OisinS13/FC_IP_rig/Control code/Interface/menu_outline.docx

1. Procedures
  1.1. Start up
  1.2. Shutdown
  1.3. Calibrate
  1.4. Idle
2. Settings
  2.1. CVM
  2.2. Data Logger
  2.3. Interface
  2.4. Load controller
  2.5. Process controller
    2.5.1. Fetch settings
    2.5.2. FTC_low_temp_thresh
    2.5.3. TC_high_temp_thresh
    2.5.4. TC_high_temp_thresh_warning_buffer
    2.5.5. Cathode_target_T
    2.5.6. Cathode_T_Hysteresis
    2.5.7. Cathode_flow_sensor_minimum_thresh
    2.5.8. CTHD_FLW_stoich
    2.5.9. CTHD_FLW_min
    2.5.10. Coolant_T_target
    2.5.11. Coolant_T_Hysteresis
    2.5.12. Coolant_high_temp_thresh
    2.5.13. Coolant_high_temp_warning_buffer
    2.5.14. HIH6120_address[8]
    2.5.15. HIH6120_flags
    2.5.16. HIH_interval
    2.5.17. P_sig_flags
    2.5.18. Pressure_sensor_minimum_threshold
    2.5.19. H2N2_flag
    2.5.20. Data_interval
  2.6. Safety controller
