OisinS13/FC_IP_rig/Hardware/Interface and data logger/JLC_BOM.xlsx

Comment | Designator | Footprint | JLCPCB Part #（optional）
5.6k | R1, R2, R3, R4, R5, R6, R7, R8, R9, R10, R11, R12, R13, R14, R15, R16, R17, R18, R19, R20, R21, R22, R23, R24, R25, R26, R27, R28, R29, R30, R31, R32, R33, R34, R35, R36, R37, R38, R39, R40, R41, R42, R43, R44, R45, R46, R47, R48, R49, R50, R51, R52, R53, R54, R55, R56, | Resistor_SMD:R_0603_1608Metric_Pad0.98x0.95mm_HandSolder | C23189
BSS138 | Q1, Q2, Q3, Q4, Q5, Q6, Q7, Q8, Q9, Q10, Q11, Q12, Q13, Q14, Q15, Q16, Q17, Q18, Q19, Q20, Q21, Q22, Q23, Q24, Q25, Q26, Q27, Q28, | Package_TO_SOT_SMD:SOT-23 | C112239
