OisinS13/FC_IP_rig/Hardware/gas sniffer/Fab_outs/gas sniffer-NPTH-drl-drl_map.dxf

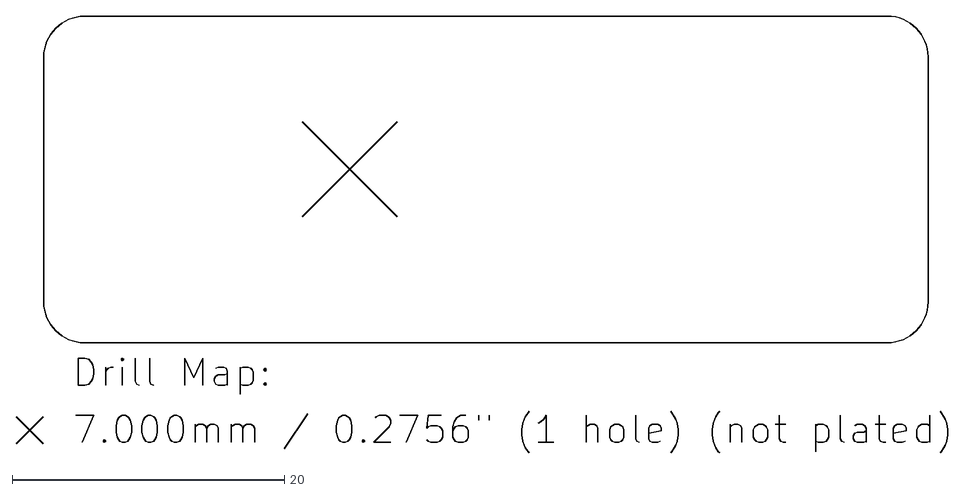
[picture p1: CAD file, 2022-11-23]
Hardware/gas sniffer/Fab_outs/gas sniffer-NPTH-drl-drl_map.dxf
68.5 x 32.1
