OisinS13/FC_IP_rig/Hardware/gas sniffer/Fab_outs/gas sniffer-PTH-drl-drl_map.dxf

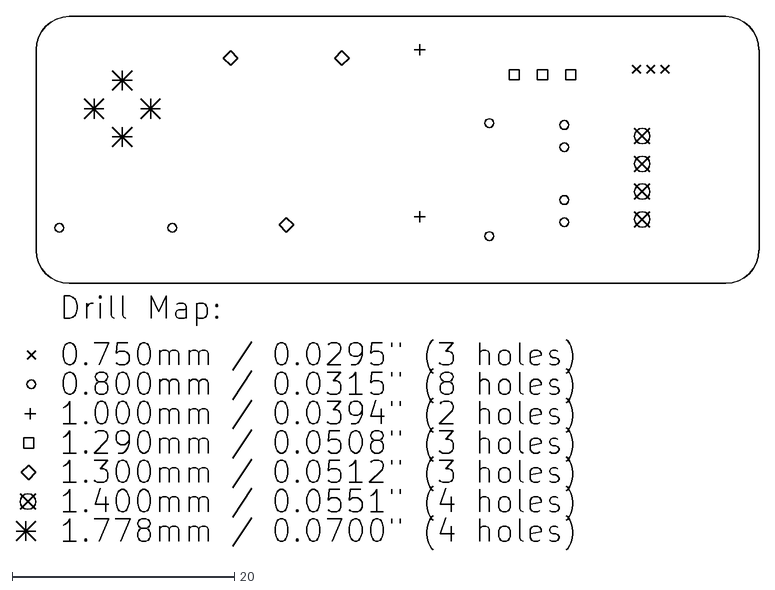
[picture p2: CAD file, 2022-11-23]
Hardware/gas sniffer/Fab_outs/gas sniffer-PTH-drl-drl_map.dxf
66.8 x 47.9
