OisinS13/FC_IP_rig/Hardware/Load controller/controlCircuit.pdf

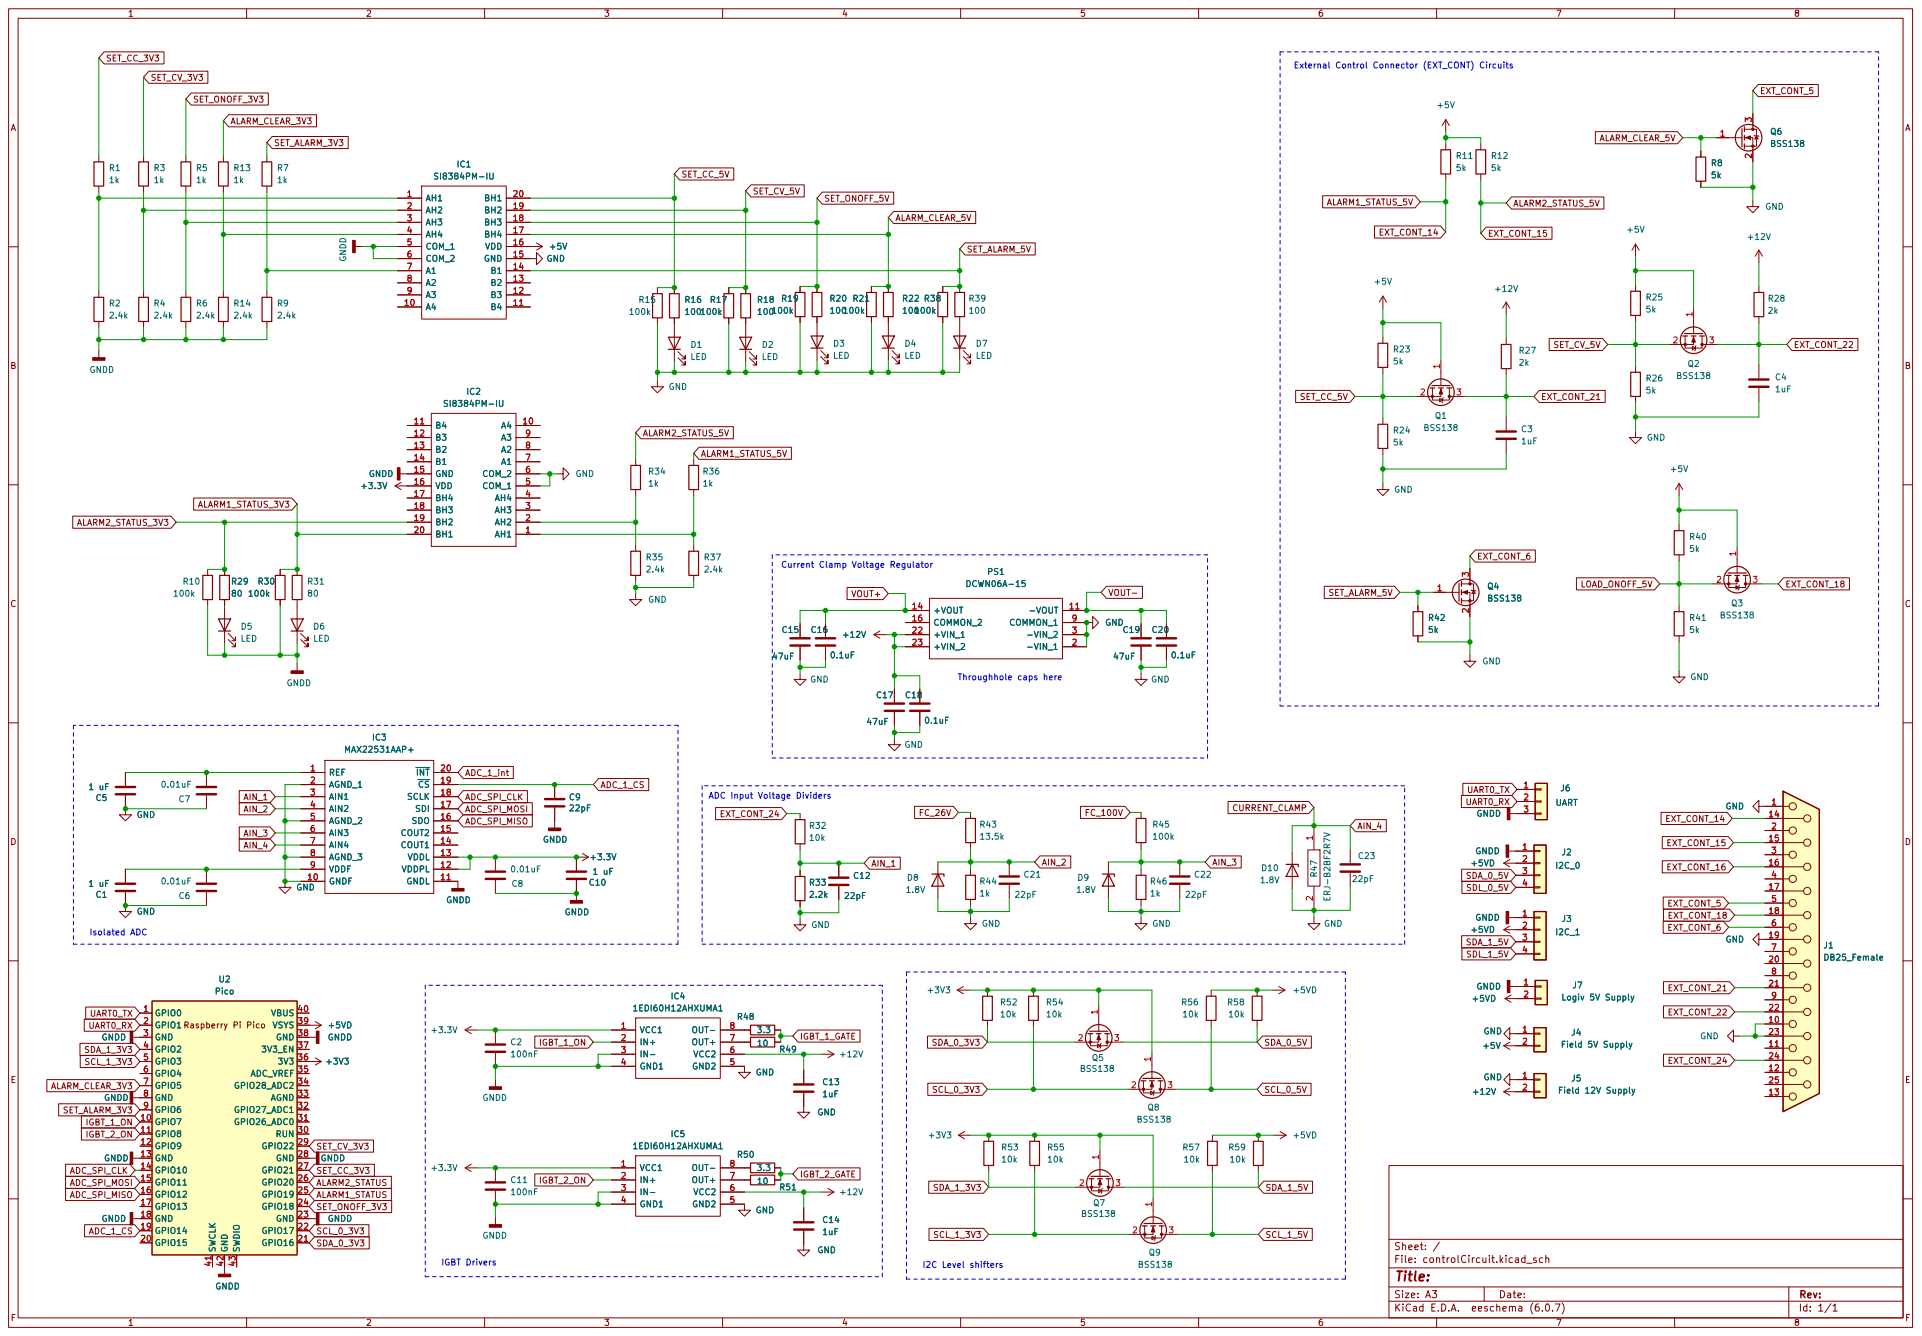
[picture p3: page 1]

External Control Connector (EXT_CONT) Circuits
EXT_CONT_21ALARM_CLEAR_5V

Current Clamp Voltage Regulator

ADC Input Voltage Dividers

+5VD GNDD GND GNDD GND

Isolated ADC
