OisinS13/FC_IP_rig/(list of files, drawings)

Other design files:
Hardware/CVM/iso_adc_cvm.dsn
Hardware/gas sniffer/gas sniffer.dsn
Hardware/Interface and data logger/Interface.dsn
Hardware/Process and safety controller/SCU rig control.dsn
Hardware/Process and safety controller/SCU rig control_ICAH.dsn
