OisinS13/FC_IP_rig/Hardware/Process and safety controller/SCU rig control.kicad_pcb

## KiCad design Hardware/Process and safety controller/SCU rig control.kicad_pcb (2022-11-23)

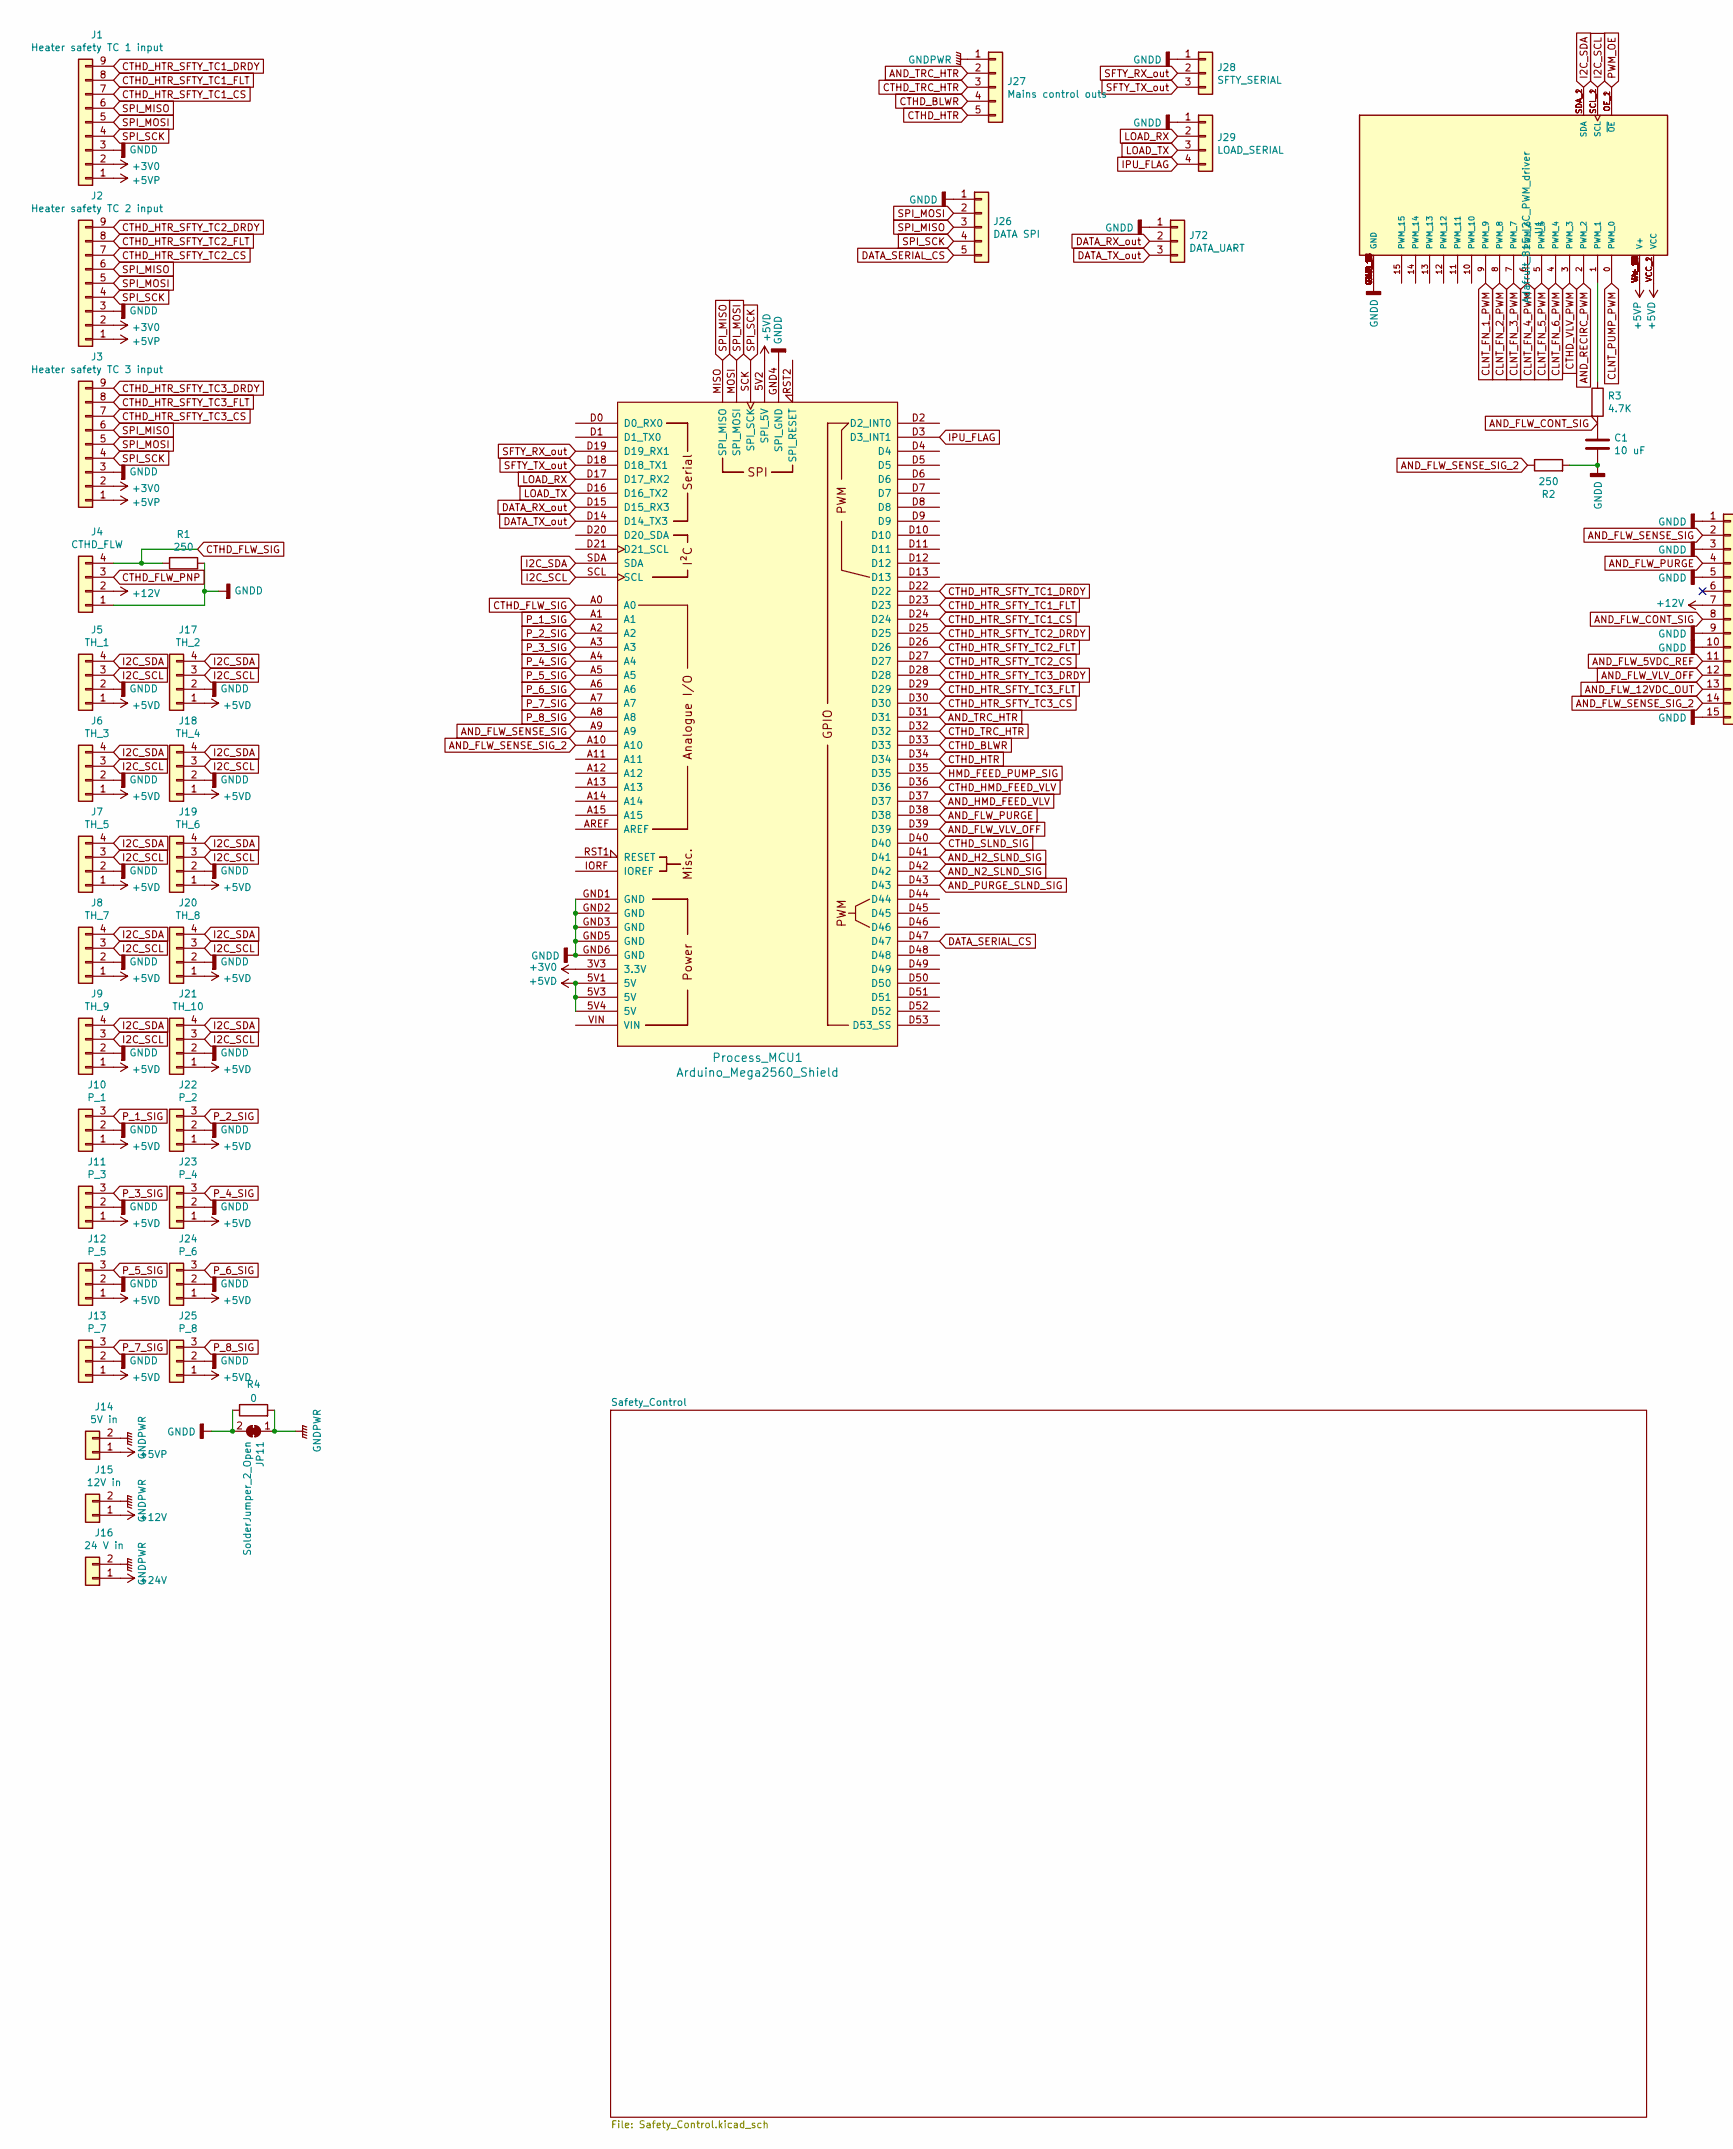
[picture p4: schematic SCU rig control.kicad_sch, part in row 1, column 1]

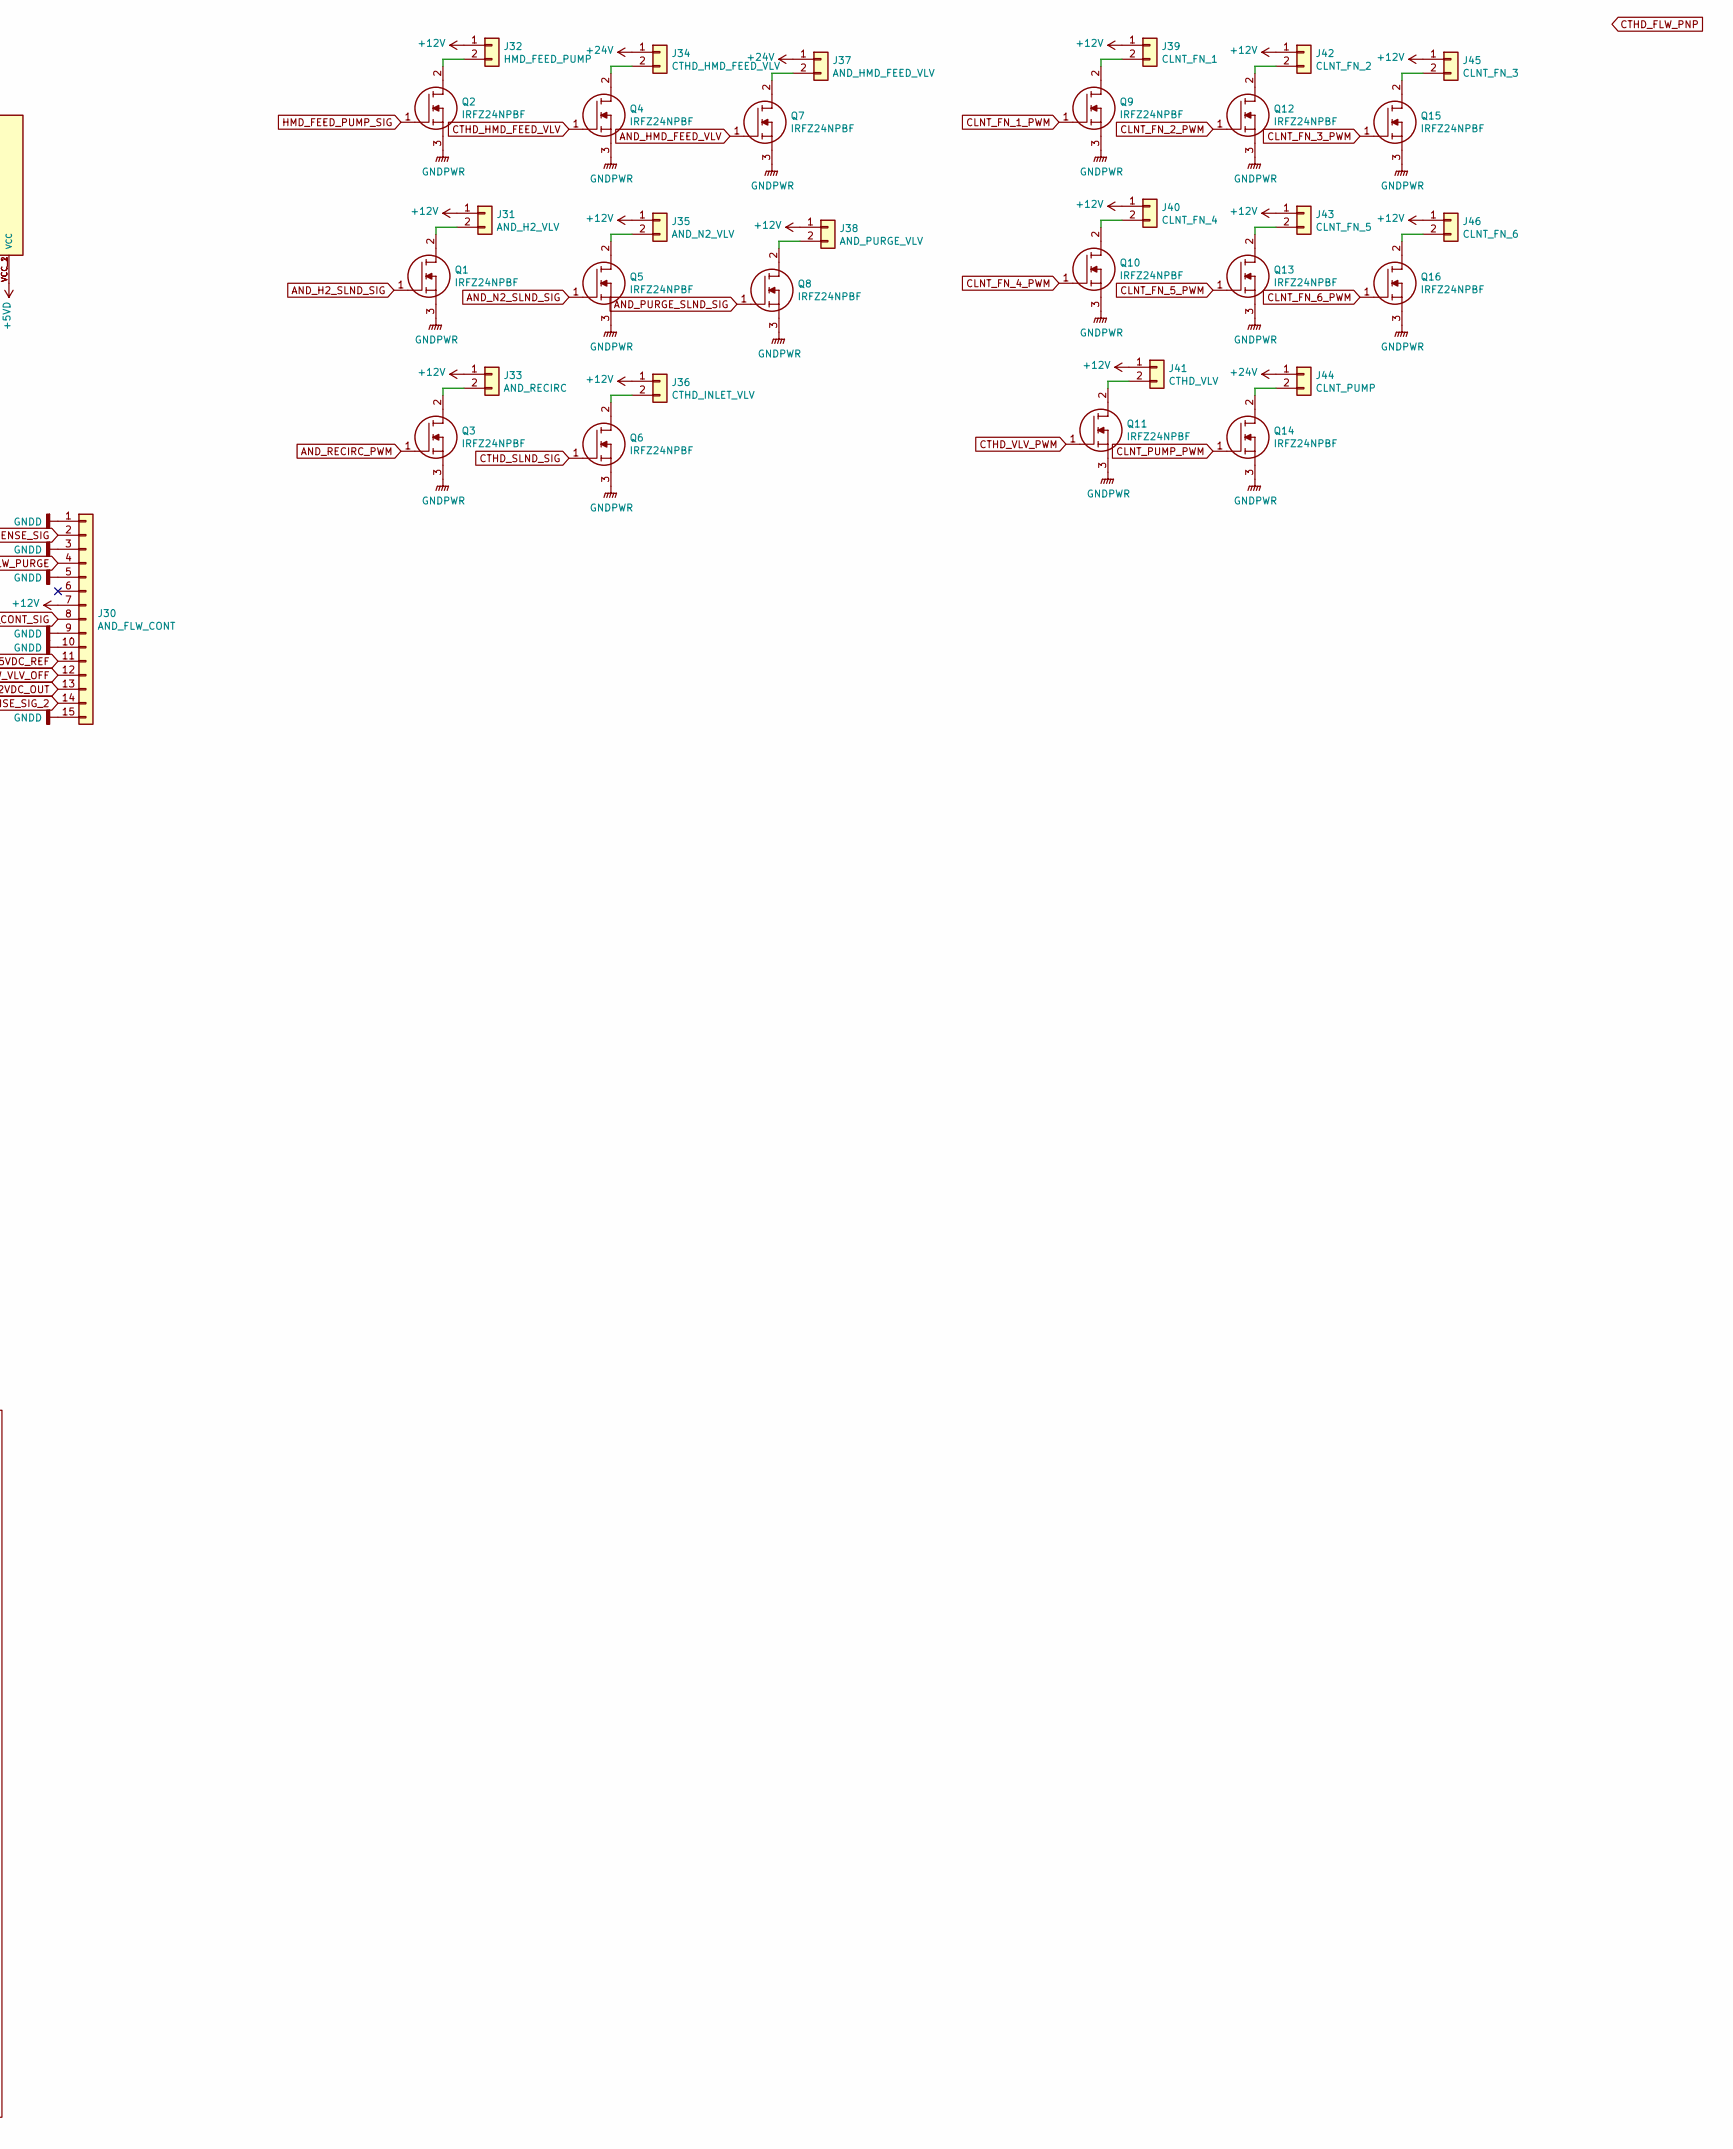
[picture p5: schematic SCU rig control.kicad_sch, part in row 1, column 2]

Parts:
C1: 10 uF; CP_Radial_D5.0mm_P2.00mm
J1: Heater safety TC 1 input; Adafruit_3263
J2: Heater safety TC 2 input; Adafruit_3263
J3: Heater safety TC 3 input; Adafruit_3263
J4: CTHD_FLW; 1963557
J5: TH_1; 1963557
J6: TH_3; 1963557
J7: TH_5; 1963557
J8: TH_7; 1963557
J9: TH_9; 1963557
J10: P_1; 1963544
J11: P_3; 1963544
J12: P_5; 1963544
J13: P_7; 1963544
J14: 5V in; 1963531
J15: 12V in; SolderWirePad_1x02_P7.62mm_Drill2.5mm
J16: 24 V in; SolderWirePad_1x02_P7.62mm_Drill2.5mm
J17: TH_2; 1963557
J18: TH_4; 1963557
J19: TH_6; 1963557
J20: TH_8; 1963557
J21: TH_10; 1963557
J22: P_2; 1963544
J23: P_4; 1963544
J24: P_6; 1963544
J25: P_8; 1963544
J26: DATA SPI; 1881587
J27: Mains control outs; 1881587
J28: SFTY_SERIAL; 1963544
J29: LOAD_SERIAL; 1963557
J30: AND_FLW_CONT; DSUB-15_Male_Vertical_P2.77x2.84mm
J31: AND_H2_VLV; 1963531
J32: HMD_FEED_PUMP; 1963531
J33: AND_RECIRC; 1963531
J34: CTHD_HMD_FEED_VLV; 1963531
J35: AND_N2_VLV; 1963531
J36: CTHD_INLET_VLV; 1963531
J37: AND_HMD_FEED_VLV; 1963531
J38: AND_PURGE_VLV; 1963531
J39: CLNT_FN_1; 1963531
J40: CLNT_FN_4; 1963531
J41: CTHD_VLV; 1963531
J42: CLNT_FN_2; 1963531
J43: CLNT_FN_5; 1963531
J44: CLNT_PUMP; 1963531
J45: CLNT_FN_3; 1963531
J46: CLNT_FN_6; 1963531
J72: DATA_UART; 1963544
JP11: SolderJumper_2_Open; SolderJumper-2_P1.3mm_Bridged2Bar_RoundedPad1.0x1.5mm
Process_MCU1: Arduino_Mega2560_Shield
Q1, Q2, Q3, Q4, Q5, Q6, Q7, Q8, Q9, Q10, Q11, Q12, Q13, Q14, Q15, Q16: IRFZ24NPBF; TO254P469X1042X1967-3P; Mouser Part Number 942-IRFZ24NPBF
R1, R2: 250; R_Axial_DIN0411_L9.9mm_D3.6mm_P15.24mm_Horizontal
R3: 4.7K; R_Axial_DIN0411_L9.9mm_D3.6mm_P15.24mm_Horizontal
R4: 0; R_Axial_DIN0411_L9.9mm_D3.6mm_P15.24mm_Horizontal
U1: Adafruit_815_I2C_PWM_driver; MODULE_815

Connections:
+3V0: J1.2, J2.2, J3.2, Process_MCU1.3V3 (3.3V)
+5VD: J5.1, J6.1, J7.1, J8.1, J9.1, J10.1, J11.1, J12.1, J13.1, J17.1, J18.1, J19.1, J20.1, J21.1, J22.1, J23.1, J24.1, J25.1, Process_MCU1.5V1 (5V), Process_MCU1.5V2 (SPI_5V), Process_MCU1.5V3 (5V), Process_MCU1.5V4 (5V), U1.VCC_1 (VCC), U1.VCC_2 (VCC)
+5VP: J1.1, J2.1, J3.1, J14.1, U1.V+_1 (V+), U1.V+_2 (V+), U1.V+_3 (V+), U1.V+_4 (V+), U1.V+_5 (V+), U1.V+_6 (V+), U1.V+_7 (V+), U1.V+_8 (V+), U1.V+_9 (V+), U1.V+_10 (V+), U1.V+_11 (V+), U1.V+_12 (V+), U1.V+_13 (V+), U1.V+_14 (V+), U1.V+_15 (V+), U1.V+_16 (V+), U1.V+_17 (V+), U1.V+_18 (V+)
+12V: J4.2, J15.1, J30.7, J31.1, J32.1, J33.1, J35.1, J36.1, J38.1, J39.1, J40.1, J41.1, J42.1, J43.1, J45.1, J46.1
+24V: J16.1, J34.1, J37.1, J44.1
AND_FLW_5VDC_REF: J30.11
AND_FLW_12VDC_OUT: J30.13
AND_FLW_CONT_SIG: C1.1, J30.8, R3.2
AND_FLW_PURGE: J30.4, Process_MCU1.D38
AND_FLW_SENSE_SIG: J30.2, Process_MCU1.A9
AND_FLW_SENSE_SIG_2: J30.14, Process_MCU1.A10, R2.1
AND_FLW_VLV_OFF: J30.12, Process_MCU1.D39
AND_H2_SLND_SIG: Process_MCU1.D41, Q1.1
AND_HMD_FEED_VLV: Process_MCU1.D37, Q7.1
AND_N2_SLND_SIG: Process_MCU1.D42, Q5.1
AND_PURGE_SLND_SIG: Process_MCU1.D43, Q8.1
AND_RECIRC_PWM: Q3.1, U1.2 (PWM_2)
AND_TRC_HTR: J27.2, Process_MCU1.D31
CLNT_FN_1_PWM: Q9.1, U1.9 (PWM_9)
CLNT_FN_2_PWM: Q12.1, U1.8 (PWM_8)
CLNT_FN_3_PWM: Q15.1, U1.7 (PWM_7)
CLNT_FN_4_PWM: Q10.1, U1.6 (PWM_6)
CLNT_FN_5_PWM: Q13.1, U1.5 (PWM_5)
CLNT_FN_6_PWM: Q16.1, U1.4 (PWM_4)
CLNT_PUMP_PWM: Q14.1, U1.0 (PWM_0)
CTHD_BLWR: J27.4, Process_MCU1.D33
CTHD_FLW_PNP: J4.3
CTHD_FLW_SIG: J4.4, Process_MCU1.A0, R1.2
CTHD_HMD_FEED_VLV: Process_MCU1.D36, Q4.1
CTHD_HTR: J27.5, Process_MCU1.D34
CTHD_HTR_SFTY_TC1_CS: J1.7, Process_MCU1.D24
CTHD_HTR_SFTY_TC1_DRDY: J1.9, Process_MCU1.D22
CTHD_HTR_SFTY_TC1_FLT: J1.8, Process_MCU1.D23
CTHD_HTR_SFTY_TC2_CS: J2.7, Process_MCU1.D27
CTHD_HTR_SFTY_TC2_DRDY: J2.9, Process_MCU1.D25
CTHD_HTR_SFTY_TC2_FLT: J2.8, Process_MCU1.D26
CTHD_HTR_SFTY_TC3_CS: J3.7, Process_MCU1.D30
CTHD_HTR_SFTY_TC3_DRDY: J3.9, Process_MCU1.D28
CTHD_HTR_SFTY_TC3_FLT: J3.8, Process_MCU1.D29
CTHD_SLND_SIG: Process_MCU1.D40, Q6.1
CTHD_TRC_HTR: J27.3, Process_MCU1.D32
CTHD_VLV_PWM: Q11.1, U1.3 (PWM_3)
DATA_RX_out: J72.2, Process_MCU1.D15 (D15_RX3)
DATA_SERIAL_CS: J26.5, Process_MCU1.D47
DATA_TX_out: J72.3, Process_MCU1.D14 (D14_TX3)
GNDD: C1.2, J1.3, J2.3, J3.3, J4.1, J5.2, J6.2, J7.2, J8.2, J9.2, J10.2, J11.2, J12.2, J13.2, J17.2, J18.2, J19.2, J20.2, J21.2, J22.2, J23.2, J24.2, J25.2, J26.1, J28.1, J29.1, J30.1, J30.3, J30.5, J30.9, J30.10, J30.15, J72.1, JP11.2 (B), Process_MCU1.GND1 (GND), Process_MCU1.GND2 (GND), Process_MCU1.GND3 (GND), Process_MCU1.GND4 (SPI_GND), Process_MCU1.GND5 (GND), Process_MCU1.GND6 (GND), R1.1, R2.2, R4.1, U1.GND_1 (GND), U1.GND_2 (GND), U1.GND_3 (GND), U1.GND_4 (GND), U1.GND_5 (GND), U1.GND_6 (GND), U1.GND_7 (GND), U1.GND_8 (GND), U1.GND_9 (GND), U1.GND_10 (GND), U1.GND_11 (GND), U1.GND_12 (GND), U1.GND_13 (GND), U1.GND_14 (GND), U1.GND_15 (GND), U1.GND_16 (GND), U1.GND_17 (GND), U1.GND_18 (GND)
GNDPWR: J14.2, J15.2, J16.2, J27.1, JP11.1 (A), Q1.3, Q2.3, Q3.3, Q4.3, Q5.3, Q6.3, Q7.3, Q8.3, Q9.3, Q10.3, Q11.3, Q12.3, Q13.3, Q14.3, Q15.3, Q16.3, R4.2
HMD_FEED_PUMP_SIG: Process_MCU1.D35, Q2.1
I2C_SCL: J5.3, J6.3, J7.3, J8.3, J9.3, J17.3, J18.3, J19.3, J20.3, J21.3, Process_MCU1.SCL, U1.SCL_1 (SCL), U1.SCL_2 (SCL)
I2C_SDA: J5.4, J6.4, J7.4, J8.4, J9.4, J17.4, J18.4, J19.4, J20.4, J21.4, Process_MCU1.SDA, U1.SDA_1 (SDA), U1.SDA_2 (SDA)
IPU_FLAG: J29.4, Process_MCU1.D3 (D3_INT1)
LOAD_RX: J29.2, Process_MCU1.D17 (D17_RX2)
LOAD_TX: J29.3, Process_MCU1.D16 (D16_TX2)
unnamed: J31.2, Q1.2
unnamed: J32.2, Q2.2
unnamed: J33.2, Q3.2
unnamed: J34.2, Q4.2
unnamed: J35.2, Q5.2
unnamed: J36.2, Q6.2
unnamed: J37.2, Q7.2
unnamed: J38.2, Q8.2
unnamed: J39.2, Q9.2
unnamed: J40.2, Q10.2
unnamed: J41.2, Q11.2
unnamed: J42.2, Q12.2
unnamed: J43.2, Q13.2
unnamed: J44.2, Q14.2
unnamed: J45.2, Q15.2
unnamed: J46.2, Q16.2
unnamed: R3.1, U1.1 (PWM_1)
PWM_OE: U1.OE_1 (~OE), U1.OE_2 (~OE)
P_1_SIG: J10.3, Process_MCU1.A1
P_2_SIG: J22.3, Process_MCU1.A2
P_3_SIG: J11.3, Process_MCU1.A3
P_4_SIG: J23.3, Process_MCU1.A4
P_5_SIG: J12.3, Process_MCU1.A5
P_6_SIG: J24.3, Process_MCU1.A6
P_7_SIG: J13.3, Process_MCU1.A7
P_8_SIG: J25.3, Process_MCU1.A8
SFTY_RX_out: J28.2, Process_MCU1.D19 (D19_RX1)
SFTY_TX_out: J28.3, Process_MCU1.D18 (D18_TX1)
SPI_MISO: J1.6, J2.6, J3.6, J26.3, Process_MCU1.MISO (SPI_MISO)
SPI_MOSI: J1.5, J2.5, J3.5, J26.2, Process_MCU1.MOSI (SPI_MOSI)
SPI_SCK: J1.4, J2.4, J3.4, J26.4, Process_MCU1.SCK (SPI_SCK)

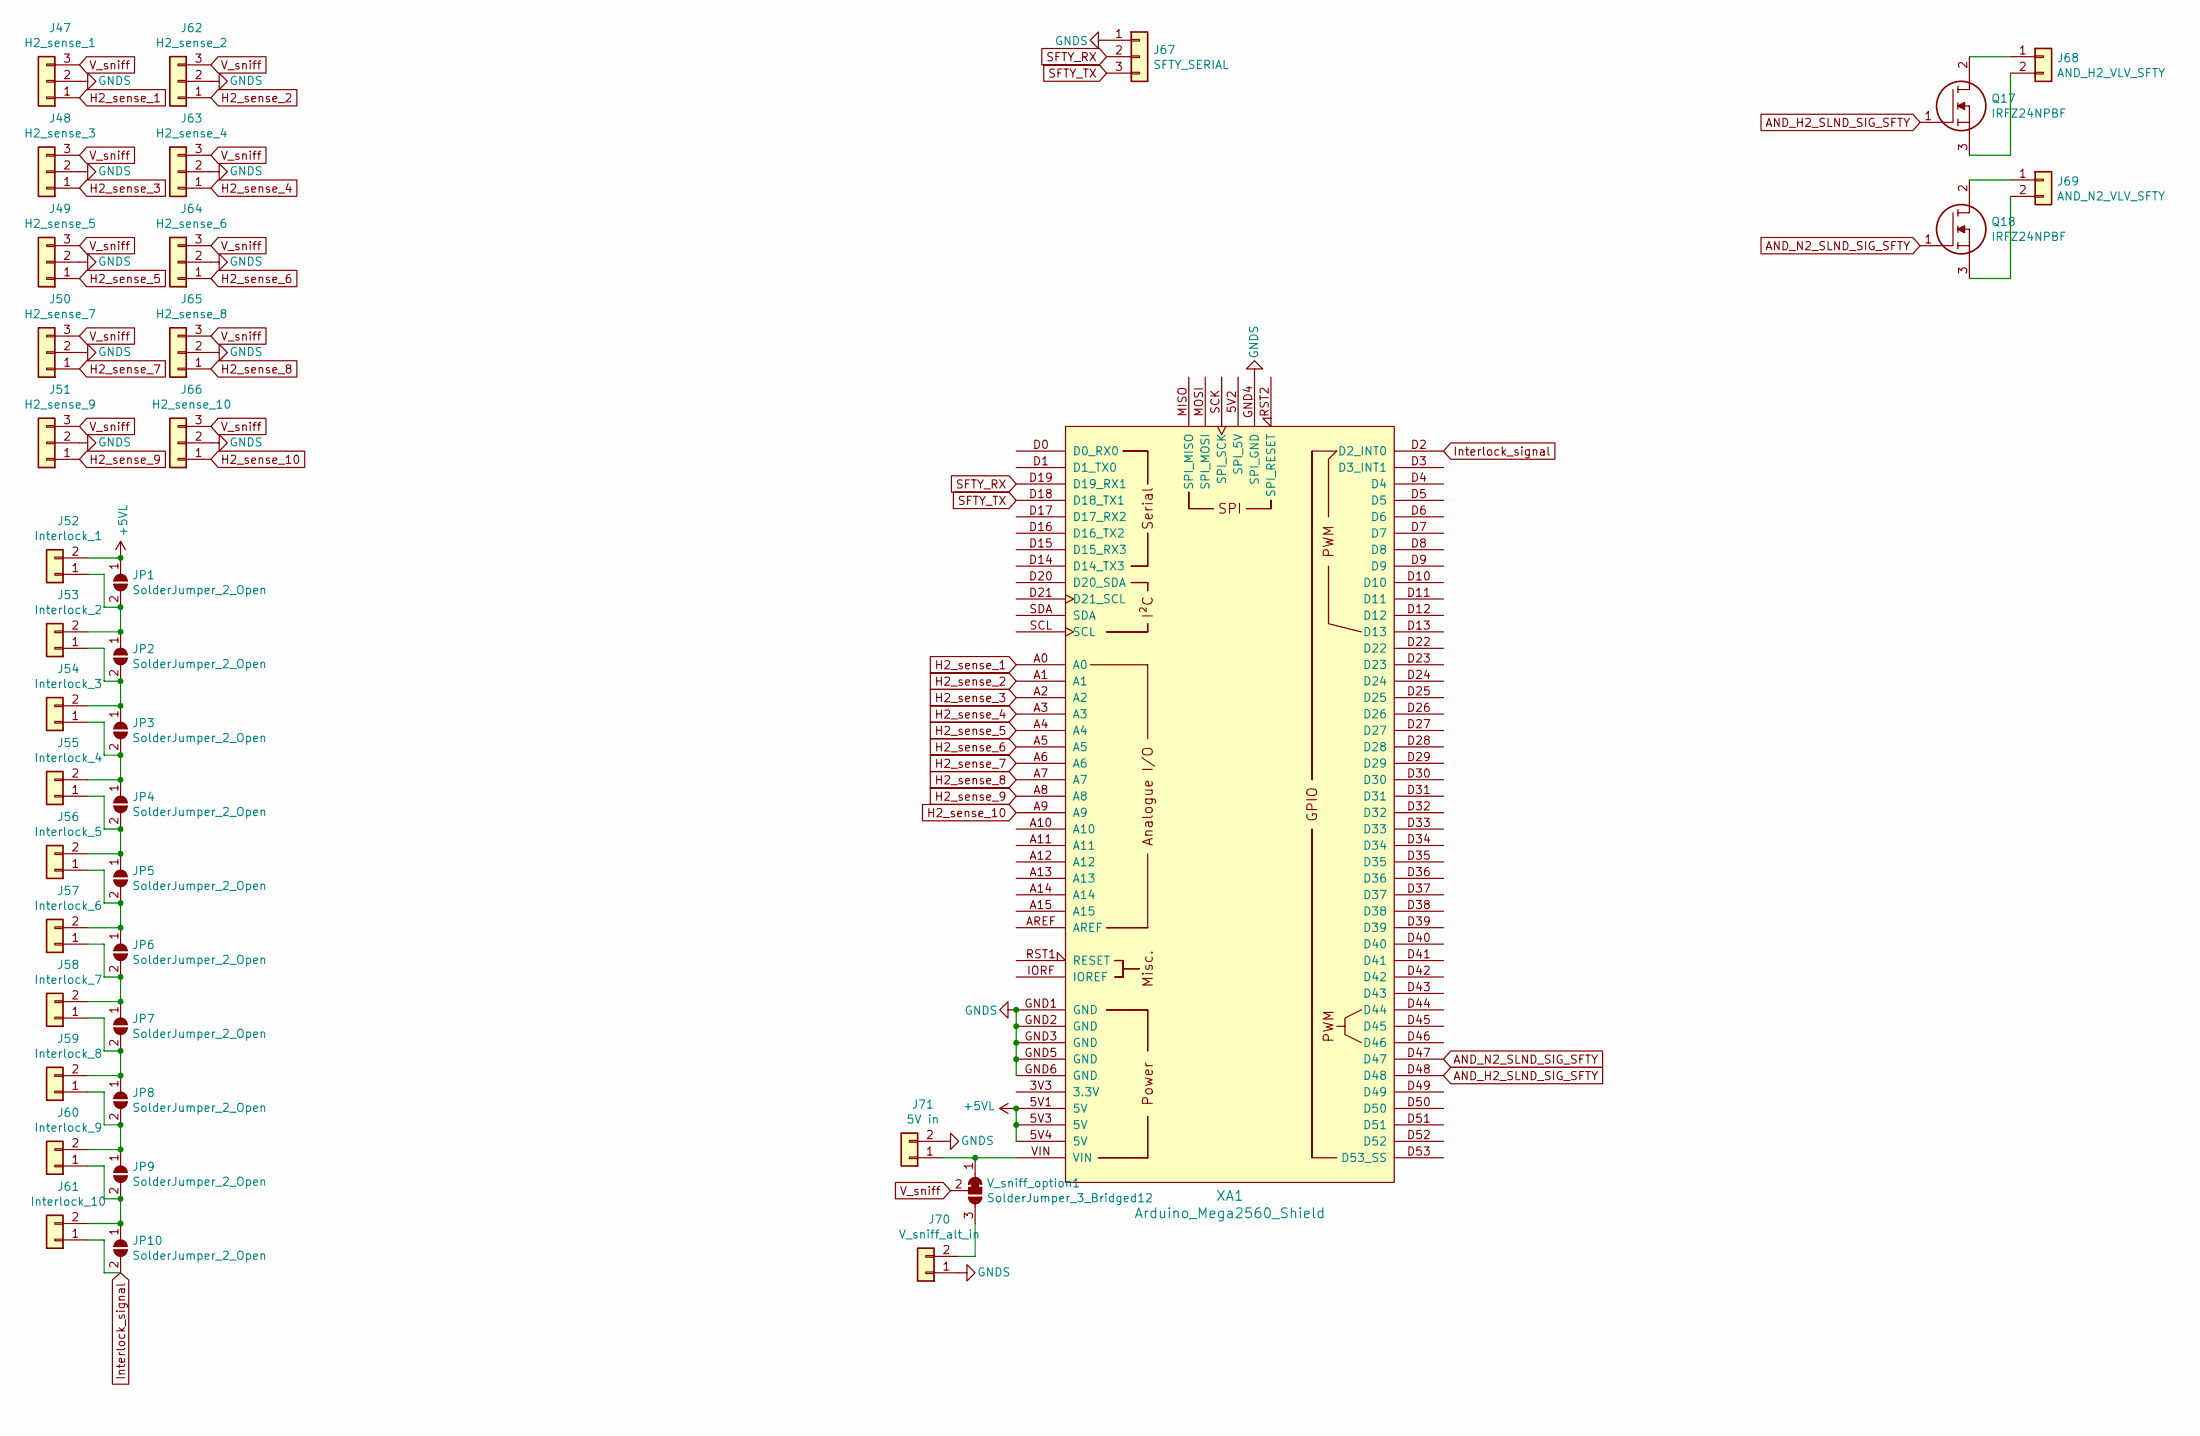
[picture p6: schematic Safety_Control.kicad_sch]

Parts:
J47: H2_sense_1; 1963544
J48: H2_sense_3; 1963544
J49: H2_sense_5; 1963544
J50: H2_sense_7; 1963544
J51: H2_sense_9; 1963544
J52: Interlock_1; 1963531
J53: Interlock_2; 1963531
J54: Interlock_3; 1963531
J55: Interlock_4; 1963531
J56: Interlock_5; 1963531
J57: Interlock_6; 1963531
J58: Interlock_7; 1963531
J59: Interlock_8; 1963531
J60: Interlock_9; 1963531
J61: Interlock_10; 1963531
J62: H2_sense_2; 1963544
J63: H2_sense_4; 1963544
J64: H2_sense_6; 1963544
J65: H2_sense_8; 1963544
J66: H2_sense_10; 1963544
J67: SFTY_SERIAL; 1963544
J68: AND_H2_VLV_SFTY; 1963531
J69: AND_N2_VLV_SFTY; 1963531
J70: V_sniff_alt_in; 1963531
J71: 5V in; 1963531
JP1, JP2, JP3, JP4, JP5, JP6, JP7, JP8, JP9, JP10: SolderJumper_2_Open; SolderJumper-2_P1.3mm_Open_RoundedPad1.0x1.5mm
Q17, Q18: IRFZ24NPBF; TO254P469X1042X1967-3P; Mouser Part Number 942-IRFZ24NPBF
V_sniff_option1: SolderJumper_3_Bridged12; SolderJumper-3_P1.3mm_Bridged12_RoundedPad1.0x1.5mm
XA1: Arduino_Mega2560_Shield

Connections:
+5VL: J52.2, JP1.1 (A), XA1.5V1 (5V), XA1.5V3 (5V), XA1.5V4 (5V)
AND_H2_SLND_SIG_SFTY: Q17.1, XA1.D48
AND_N2_SLND_SIG_SFTY: Q18.1, XA1.D47
GNDS: J47.2, J48.2, J49.2, J50.2, J51.2, J62.2, J63.2, J64.2, J65.2, J66.2, J67.1, J70.1, J71.2, XA1.GND1 (GND), XA1.GND2 (GND), XA1.GND3 (GND), XA1.GND4 (SPI_GND), XA1.GND5 (GND), XA1.GND6 (GND)
H2_sense_1: J47.1, XA1.A0
H2_sense_2: J62.1, XA1.A1
H2_sense_3: J48.1, XA1.A2
H2_sense_4: J63.1, XA1.A3
H2_sense_5: J49.1, XA1.A4
H2_sense_6: J64.1, XA1.A5
H2_sense_7: J50.1, XA1.A6
H2_sense_8: J65.1, XA1.A7
H2_sense_9: J51.1, XA1.A8
H2_sense_10: J66.1, XA1.A9
Interlock_signal: J61.1, JP10.2 (B), XA1.D2 (D2_INT0)
unnamed: J52.1, J53.2, JP1.2 (B), JP2.1 (A)
unnamed: J53.1, J54.2, JP2.2 (B), JP3.1 (A)
unnamed: J54.1, J55.2, JP3.2 (B), JP4.1 (A)
unnamed: J55.1, J56.2, JP4.2 (B), JP5.1 (A)
unnamed: J56.1, J57.2, JP5.2 (B), JP6.1 (A)
unnamed: J57.1, J58.2, JP6.2 (B), JP7.1 (A)
unnamed: J58.1, J59.2, JP7.2 (B), JP8.1 (A)
unnamed: J59.1, J60.2, JP8.2 (B), JP9.1 (A)
unnamed: J60.1, J61.2, JP9.2 (B), JP10.1 (A)
unnamed: J68.1, Q17.2
unnamed: J68.2, Q17.3
unnamed: J69.1, Q18.2
unnamed: J69.2, Q18.3
unnamed: J70.2, V_sniff_option1.3 (B)
unnamed: J71.1, V_sniff_option1.1 (A), XA1.VIN
SFTY_RX: J67.2, XA1.D19 (D19_RX1)
SFTY_TX: J67.3, XA1.D18 (D18_TX1)
V_sniff: J47.3, J48.3, J49.3, J50.3, J51.3, J62.3, J63.3, J64.3, J65.3, J66.3, V_sniff_option1.2 (C)

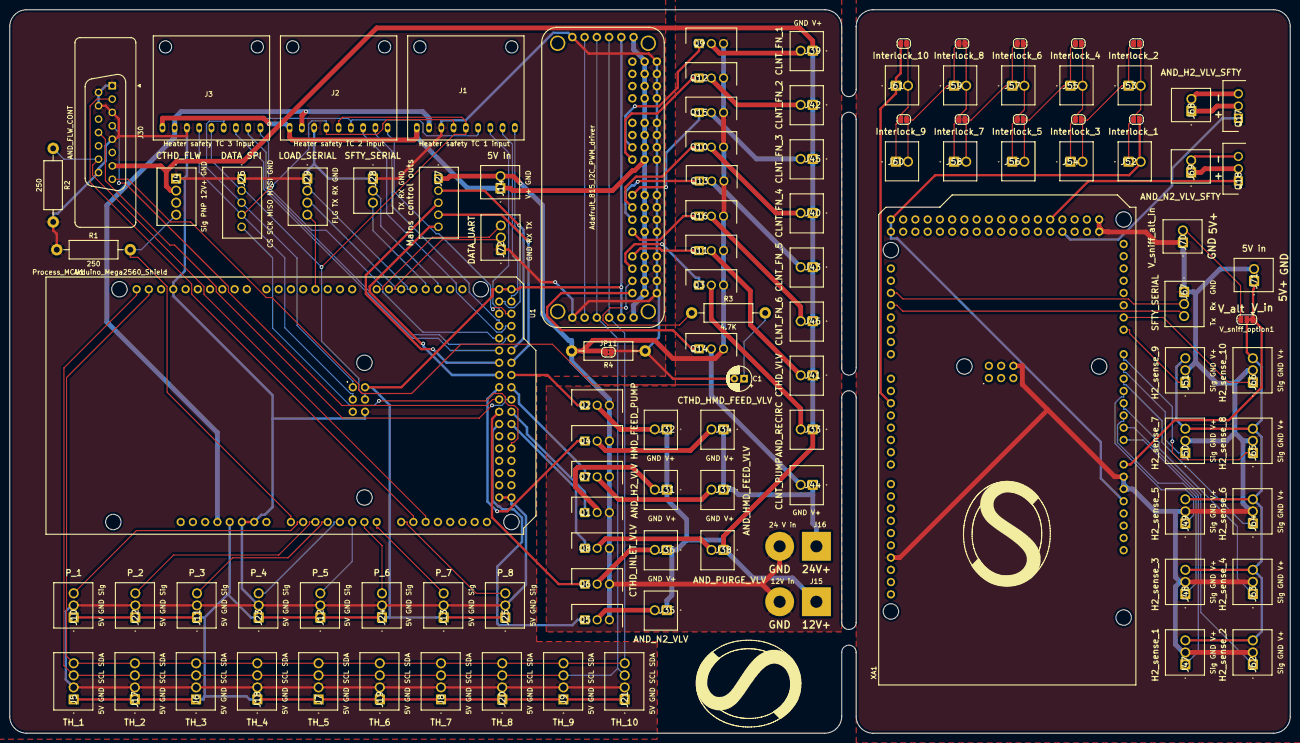
[picture p7: board SCU rig control.kicad_pcb from above]

Board: 2 copper layers, 265.5 x 150.0 mm, 110 parts (0 on the bottom side), 114 nets.
