OisinS13/FC_IP_rig/Hardware/Interface and data logger/Interface.kicad_pcb

## KiCad design Hardware/Interface and data logger/Interface.kicad_pcb (2022-11-23)

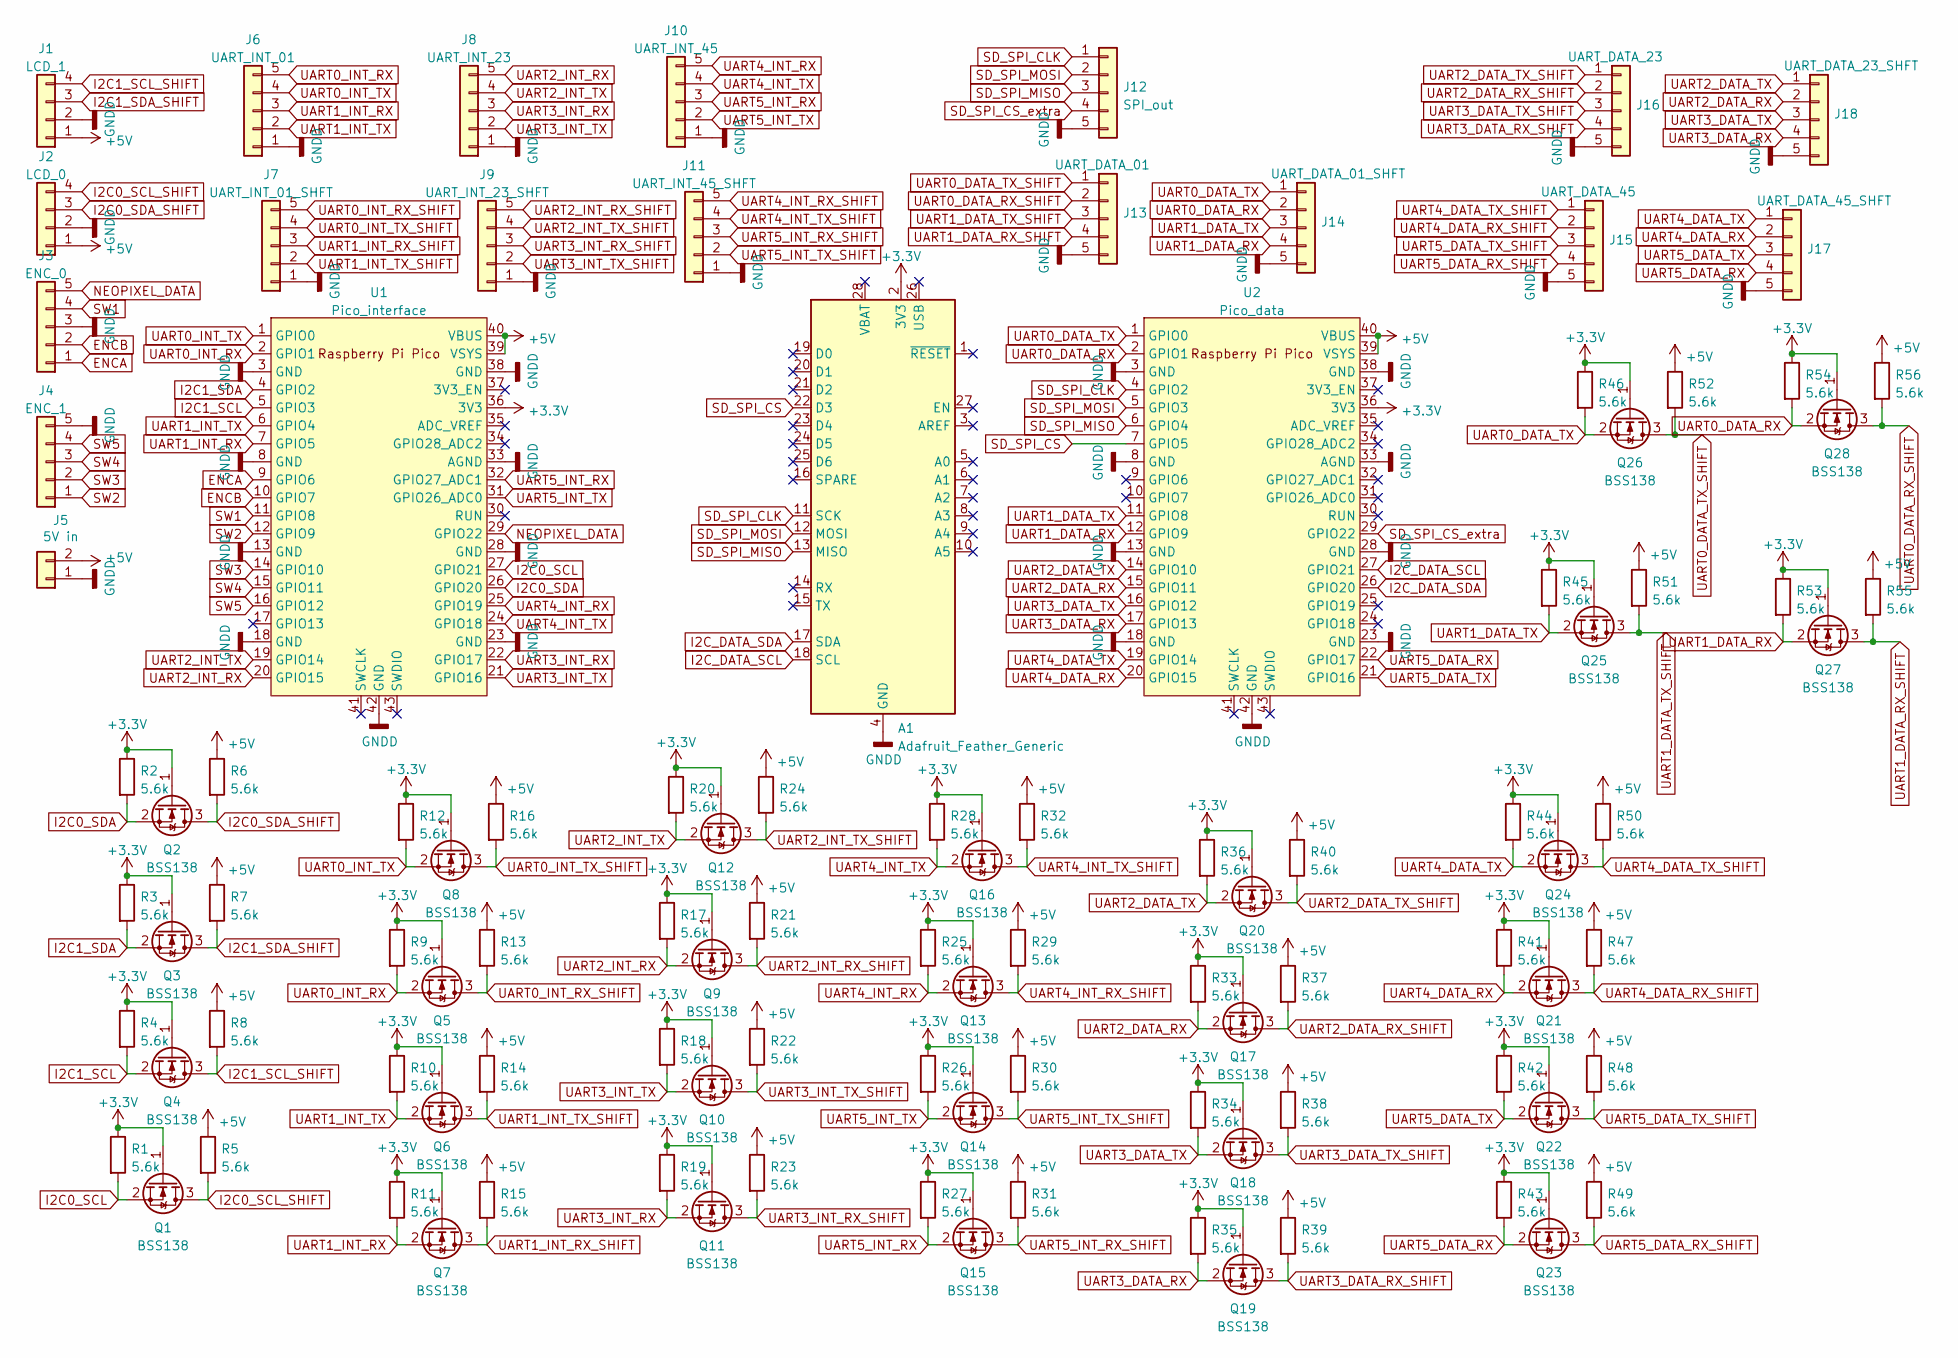
[picture p8: schematic Interface.kicad_sch]

Parts:
A1: Adafruit_Feather_Generic; Adafruit_Feather
J1: LCD_1; 1963557
J2: LCD_0; 1963557
J3: ENC_0; 1881587
J4: ENC_1; 1881587
J5: 5V in; 1963531
J6: UART_INT_01; 1881587
J7: UART_INT_01_SHFT; 1881587
J8: UART_INT_23; 1881587
J9: UART_INT_23_SHFT; 1881587
J10: UART_INT_45; 1881587
J11: UART_INT_45_SHFT; 1881587
J12: SPI_out; 1881587
J13: UART_DATA_01; 1881587
J14: UART_DATA_01_SHFT; 1881587
J15: UART_DATA_45; 1881587
J16: UART_DATA_23; 1881587
J17: UART_DATA_45_SHFT; 1881587
J18: UART_DATA_23_SHFT; 1881587
Q1, Q2, Q3, Q4, Q5, Q6, Q7, Q8, Q9, Q10, Q11, Q12, Q13, Q14, Q15, Q16, Q17, Q18, Q19, Q20, Q21, Q22, Q23, Q24, Q25, Q26, Q27, Q28: BSS138; SOT-23
R1, R2, R3, R4, R5, R6, R7, R8, R9, R10, R11, R12, R13, R14, R15, R16, R17, R18, R19, R20, R21, R22, R23, R24, R25, R26, R27, R28, R29, R30, R31, R32, R33, R34, R35, R36, R37, R38, R39, R40, R41, R42, R43, R44, R45, R46, R47, R48, R49, R50, R51, R52, R53, R54, R55, R56: 5.6k; R_0603_1608Metric_Pad0.98x0.95mm_HandSolder
U1: Pico_interface; RPi_Pico_SMD_TH
U2: Pico_data; RPi_Pico_SMD_TH

Connections:
+3.3V: A1.2 (3V3), Q1.1 (G), Q2.1 (G), Q3.1 (G), Q4.1 (G), Q5.1 (G), Q6.1 (G), Q7.1 (G), Q8.1 (G), Q9.1 (G), Q10.1 (G), Q11.1 (G), Q12.1 (G), Q13.1 (G), Q14.1 (G), Q15.1 (G), Q16.1 (G), Q17.1 (G), Q18.1 (G), Q19.1 (G), Q20.1 (G), Q21.1 (G), Q22.1 (G), Q23.1 (G), Q24.1 (G), Q25.1 (G), Q26.1 (G), Q27.1 (G), Q28.1 (G), R1.1, R2.1, R3.1, R4.1, R9.1, R10.1, R11.1, R12.1, R17.1, R18.1, R19.1, R20.1, R25.1, R26.1, R27.1, R28.1, R33.1, R34.1, R35.1, R36.1, R41.1, R42.1, R43.1, R44.1, R45.1, R46.1, R53.1, R54.1, U1.36 (3V3), U2.36 (3V3)
+5V: J1.1, J2.1, J5.2, R5.1, R6.1, R7.1, R8.1, R13.1, R14.1, R15.1, R16.1, R21.1, R22.1, R23.1, R24.1, R29.1, R30.1, R31.1, R32.1, R37.1, R38.1, R39.1, R40.1, R47.1, R48.1, R49.1, R50.1, R51.1, R52.1, R55.1, R56.1, U1.39 (VSYS), U1.40 (VBUS), U2.39 (VSYS), U2.40 (VBUS)
ENCA: J3.1, U1.9 (GPIO6)
ENCB: J3.2, U1.10 (GPIO7)
GNDD: A1.4 (GND), J1.2, J2.2, J3.3, J4.5, J5.1, J6.1, J7.1, J8.1, J9.1, J10.1, J11.1, J12.5, J13.5, J14.5, J15.5, J16.5, J17.5, J18.5, U1.3 (GND), U1.8 (GND), U1.13 (GND), U1.18 (GND), U1.23 (GND), U1.28 (GND), U1.33 (AGND), U1.38 (GND), U1.42 (GND), U2.3 (GND), U2.8 (GND), U2.13 (GND), U2.18 (GND), U2.23 (GND), U2.28 (GND), U2.33 (AGND), U2.38 (GND), U2.42 (GND)
I2C0_SCL: Q1.2 (S), R1.2, U1.27 (GPIO21)
I2C0_SCL_SHIFT: J2.4, Q1.3 (D), R5.2
I2C0_SDA: Q2.2 (S), R2.2, U1.26 (GPIO20)
I2C0_SDA_SHIFT: J2.3, Q2.3 (D), R6.2
I2C1_SCL: Q4.2 (S), R4.2, U1.5 (GPIO3)
I2C1_SCL_SHIFT: J1.4, Q4.3 (D), R8.2
I2C1_SDA: Q3.2 (S), R3.2, U1.4 (GPIO2)
I2C1_SDA_SHIFT: J1.3, Q3.3 (D), R7.2
I2C_DATA_SCL: A1.18 (SCL), U2.27 (GPIO21)
I2C_DATA_SDA: A1.17 (SDA), U2.26 (GPIO20)
NEOPIXEL_DATA: J3.5, U1.29 (GPIO22)
SD_SPI_CLK: A1.11 (SCK), J12.1, U2.4 (GPIO2)
SD_SPI_CS: A1.22 (D3), U2.7 (GPIO5)
SD_SPI_CS_extra: J12.4, U2.29 (GPIO22)
SD_SPI_MISO: A1.13 (MISO), J12.3, U2.6 (GPIO4)
SD_SPI_MOSI: A1.12 (MOSI), J12.2, U2.5 (GPIO3)
SW1: J3.4, U1.11 (GPIO8)
SW2: J4.1, U1.12 (GPIO9)
SW3: J4.2, U1.14 (GPIO10)
SW4: J4.3, U1.15 (GPIO11)
SW5: J4.4, U1.16 (GPIO12)
UART0_DATA_RX: J14.2, Q28.2 (S), R54.2, U2.2 (GPIO1)
UART0_DATA_RX_SHIFT: J13.2, Q28.3 (D), R56.2
UART0_DATA_TX: J14.1, Q26.2 (S), R46.2, U2.1 (GPIO0)
UART0_DATA_TX_SHIFT: J13.1, Q26.3 (D), R52.2
UART0_INT_RX: J6.5, Q5.2 (S), R9.2, U1.2 (GPIO1)
UART0_INT_RX_SHIFT: J7.5, Q5.3 (D), R13.2
UART0_INT_TX: J6.4, Q8.2 (S), R12.2, U1.1 (GPIO0)
UART0_INT_TX_SHIFT: J7.4, Q8.3 (D), R16.2
UART1_DATA_RX: J14.4, Q27.2 (S), R53.2, U2.12 (GPIO9)
UART1_DATA_RX_SHIFT: J13.4, Q27.3 (D), R55.2
UART1_DATA_TX: J14.3, Q25.2 (S), R45.2, U2.11 (GPIO8)
UART1_DATA_TX_SHIFT: J13.3, Q25.3 (D), R51.2
UART1_INT_RX: J6.3, Q7.2 (S), R11.2, U1.7 (GPIO5)
UART1_INT_RX_SHIFT: J7.3, Q7.3 (D), R15.2
UART1_INT_TX: J6.2, Q6.2 (S), R10.2, U1.6 (GPIO4)
UART1_INT_TX_SHIFT: J7.2, Q6.3 (D), R14.2
UART2_DATA_RX: J18.2, Q17.2 (S), R33.2, U2.15 (GPIO11)
UART2_DATA_RX_SHIFT: J16.2, Q17.3 (D), R37.2
UART2_DATA_TX: J18.1, Q20.2 (S), R36.2, U2.14 (GPIO10)
UART2_DATA_TX_SHIFT: J16.1, Q20.3 (D), R40.2
UART2_INT_RX: J8.5, Q9.2 (S), R17.2, U1.20 (GPIO15)
UART2_INT_RX_SHIFT: J9.5, Q9.3 (D), R21.2
UART2_INT_TX: J8.4, Q12.2 (S), R20.2, U1.19 (GPIO14)
UART2_INT_TX_SHIFT: J9.4, Q12.3 (D), R24.2
UART3_DATA_RX: J18.4, Q19.2 (S), R35.2, U2.17 (GPIO13)
UART3_DATA_RX_SHIFT: J16.4, Q19.3 (D), R39.2
UART3_DATA_TX: J18.3, Q18.2 (S), R34.2, U2.16 (GPIO12)
UART3_DATA_TX_SHIFT: J16.3, Q18.3 (D), R38.2
UART3_INT_RX: J8.3, Q11.2 (S), R19.2, U1.22 (GPIO17)
UART3_INT_RX_SHIFT: J9.3, Q11.3 (D), R23.2
UART3_INT_TX: J8.2, Q10.2 (S), R18.2, U1.21 (GPIO16)
UART3_INT_TX_SHIFT: J9.2, Q10.3 (D), R22.2
UART4_DATA_RX: J17.2, Q21.2 (S), R41.2, U2.20 (GPIO15)
UART4_DATA_RX_SHIFT: J15.2, Q21.3 (D), R47.2
UART4_DATA_TX: J17.1, Q24.2 (S), R44.2, U2.19 (GPIO14)
UART4_DATA_TX_SHIFT: J15.1, Q24.3 (D), R50.2
UART4_INT_RX: J10.5, Q13.2 (S), R25.2, U1.25 (GPIO19)
UART4_INT_RX_SHIFT: J11.5, Q13.3 (D), R29.2
UART4_INT_TX: J10.4, Q16.2 (S), R28.2, U1.24 (GPIO18)
UART4_INT_TX_SHIFT: J11.4, Q16.3 (D), R32.2
UART5_DATA_RX: J17.4, Q23.2 (S), R43.2, U2.22 (GPIO17)
UART5_DATA_RX_SHIFT: J15.4, Q23.3 (D), R49.2
UART5_DATA_TX: J17.3, Q22.2 (S), R42.2, U2.21 (GPIO16)
UART5_DATA_TX_SHIFT: J15.3, Q22.3 (D), R48.2
UART5_INT_RX: J10.3, Q15.2 (S), R27.2, U1.32 (GPIO27_ADC1)
UART5_INT_RX_SHIFT: J11.3, Q15.3 (D), R31.2
UART5_INT_TX: J10.2, Q14.2 (S), R26.2, U1.31 (GPIO26_ADC0)
UART5_INT_TX_SHIFT: J11.2, Q14.3 (D), R30.2
