OisinS13/FC_IP_rig/Hardware/Interface and data logger/Interface.kicad_pcb

## KiCad design Hardware/Interface and data logger/Interface.kicad_pcb (continued)

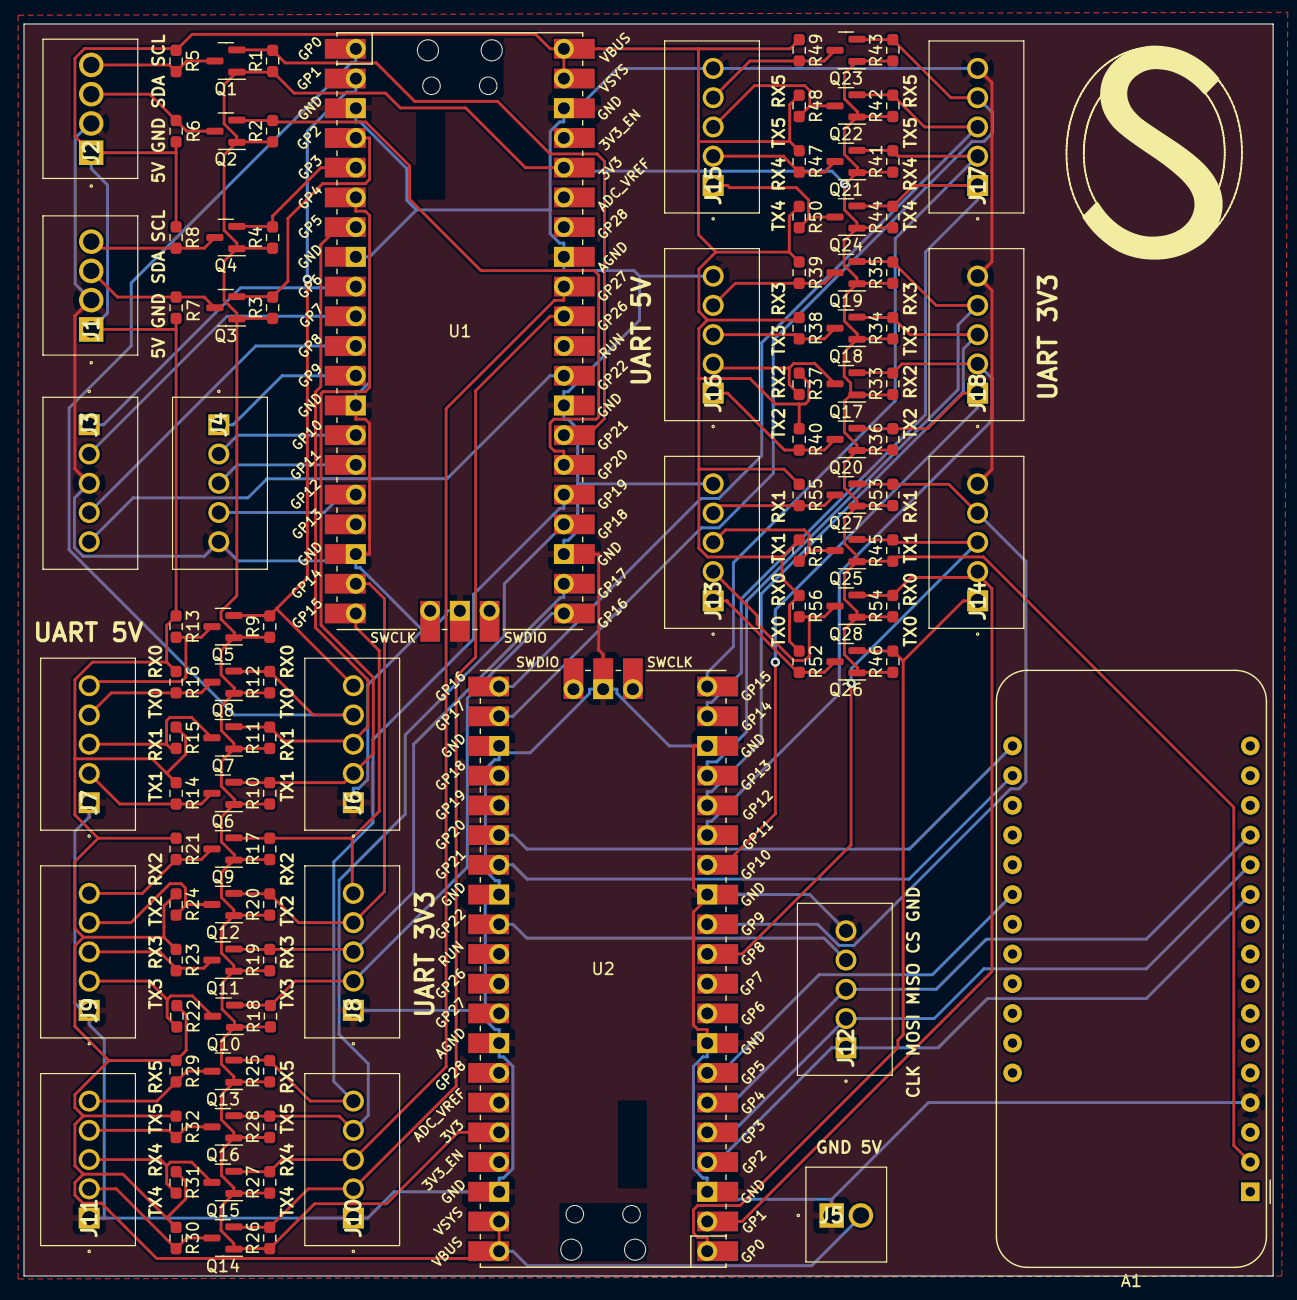
[picture p9: board Interface.kicad_pcb from above]

Board: 2 copper layers, 106.8 x 107.0 mm, 105 parts (0 on the bottom side), 74 nets.
