OisinS13/FC_IP_rig/Hardware/Load controller/controlCircuit.kicad_pcb

## KiCad design Hardware/Load controller/controlCircuit.kicad_pcb (2022-11-23)

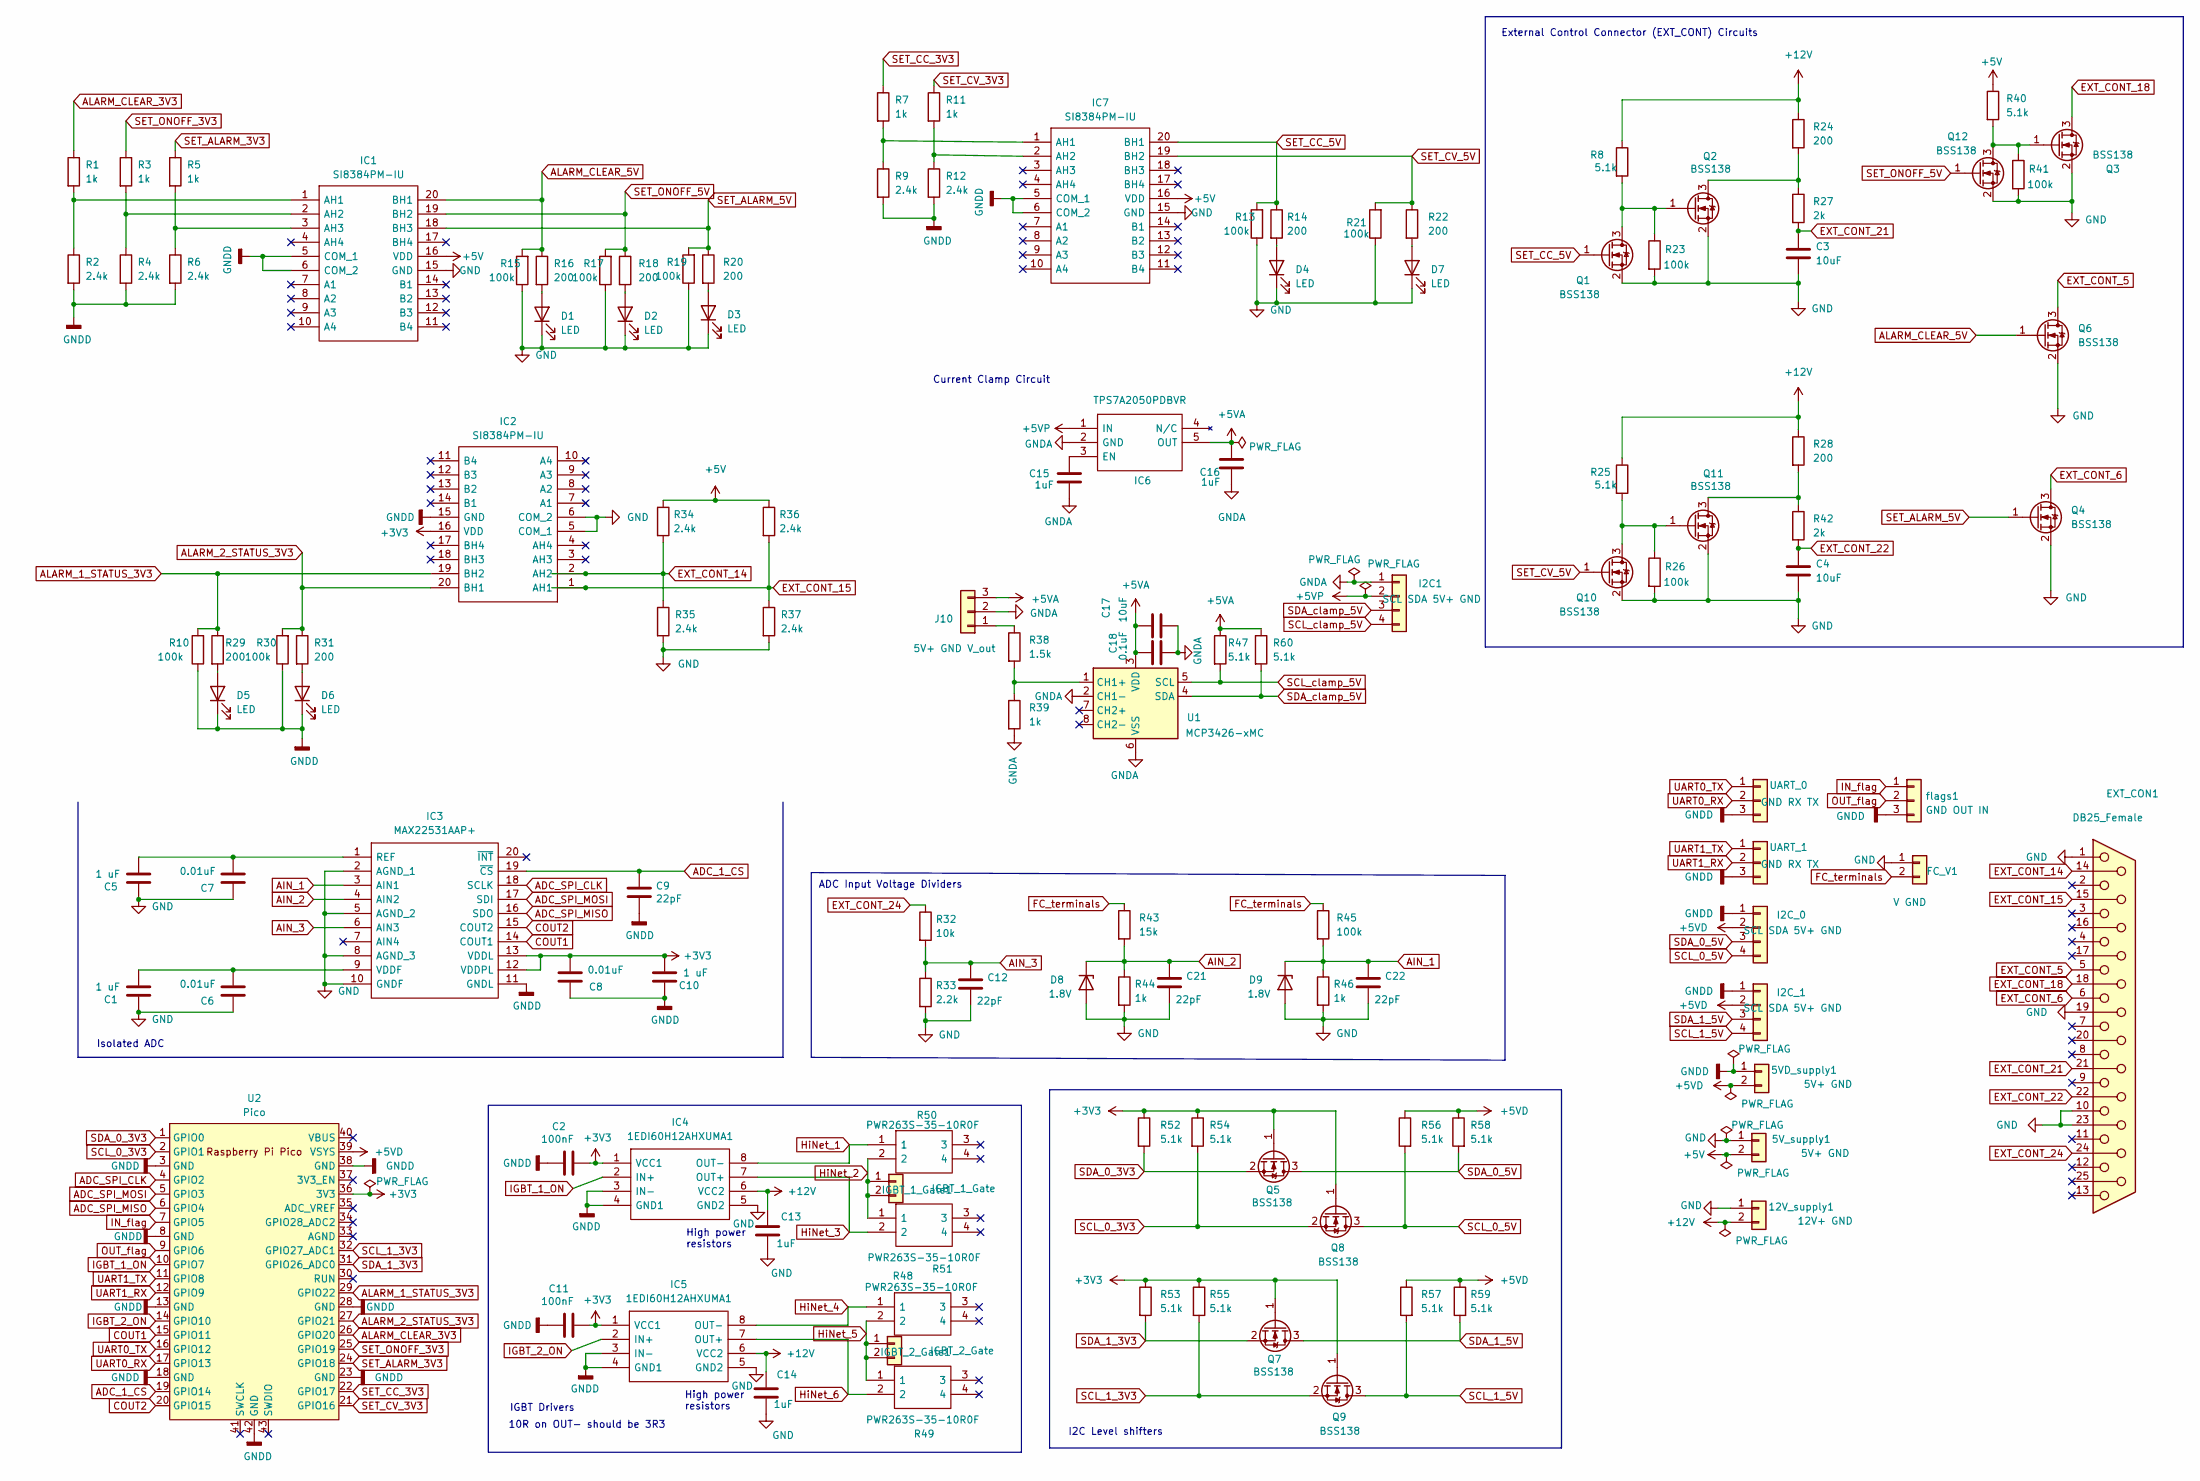
[picture p10: schematic controlCircuit.kicad_sch]

Parts:
5VD_supply1, 5V_supply1: 5V+ GND; 1963531
12V_supply1: 12V+ GND; 1963531
C1, C5, C10: 1 uF; C_0603_1608Metric_Pad1.08x0.95mm_HandSolder
C2, C11: 100nF; C_0603_1608Metric_Pad1.08x0.95mm_HandSolder
C3, C4: 10uF; CP_Radial_D4.0mm_P2.00mm
C6, C7, C8: 0.01uF; C_0603_1608Metric_Pad1.08x0.95mm_HandSolder
C9, C12, C21, C22: 22pF; C_0603_1608Metric_Pad1.08x0.95mm_HandSolder
C13, C14, C15, C16: 1uF; C_0603_1608Metric_Pad1.08x0.95mm_HandSolder
C17: 10uF; C_0603_1608Metric_Pad1.08x0.95mm_HandSolder
C18: 0.1uF; C_0603_1608Metric_Pad1.08x0.95mm_HandSolder
D1, D2, D3, D4, D5, D6, D7: LED; LED_0603_1608Metric_Pad1.05x0.95mm_HandSolder
D8, D9: 1.8V; SOD3716X135N
EXT_CON1: DB25_Female; ID25S33E4GX00LF
FC_V1: V GND; 1963531
I2C1, I2C_0, I2C_1: SCL SDA 5V+ GND; 1963557
IC1, IC2, IC7: SI8384PM-IU; SOP64P600X175-20N; Mouser Part Number 634-SI8384PM-IU
IC3: MAX22531AAP+; SOP65P778X199-20N; Mouser Part Number 700-MAX22531AAP+
IC4, IC5: 1EDI60H12AHXUMA1; SOIC127P1030X265-8N; Mouser Part Number 726-1EDI60H12AHXUMA1
IC6: TPS7A2050PDBVR; SOT95P280X145-5N; Mouser Part Number 595-TPS7A2050PDBVR
IGBT_1_Gate1: IGBT_1_Gate; 1963531
IGBT_2_Gate1: IGBT_2_Gate; 1963531
J10: 5V+ GND V_out; L06P400S05_footprint
Q1, Q2, Q3, Q4, Q5, Q6, Q7, Q8, Q9, Q10, Q11, Q12: BSS138; SOT-23
R1, R3, R5, R7, R11, R39, R44, R46: 1k; R_0603_1608Metric_Pad0.98x0.95mm_HandSolder
R2, R4, R6, R9, R12, R34, R35, R36, R37: 2.4k; R_0603_1608Metric_Pad0.98x0.95mm_HandSolder
R8, R25, R40, R47, R52, R53, R54, R55, R56, R57, R58, R59, R60: 5.1k; R_0603_1608Metric_Pad0.98x0.95mm_HandSolder
R10, R13, R15, R17, R19, R21, R23, R26, R30, R41, R45: 100k; R_0603_1608Metric_Pad0.98x0.95mm_HandSolder
R14, R16, R18, R20, R22, R24, R28, R29, R31: 200; R_0603_1608Metric_Pad0.98x0.95mm_HandSolder
R27, R42: 2k; R_0603_1608Metric_Pad0.98x0.95mm_HandSolder
R32: 10k; R_0603_1608Metric_Pad0.98x0.95mm_HandSolder
R33: 2.2k; R_0603_1608Metric_Pad0.98x0.95mm_HandSolder
R38: 1.5k; R_0603_1608Metric_Pad0.98x0.95mm_HandSolder
R43: 15k; R_0603_1608Metric_Pad0.98x0.95mm_HandSolder
R48, R49, R50, R51: PWR263S-35-10R0F; PWR263S3510R0F; Mouser Part Number 652-PWR263S3510R0F
U1: MCP3426-xMC; DFN-8-1EP_3x2mm_P0.5mm_EP1.75x1.45mm
U2: Pico; RPi_Pico_SMD_TH
UART_0, UART_1: GND RX TX; 1963544
flags1: GND OUT IN; 1963544

Connections:
+3V3: C2.2, C8.2, C10.1, C11.2, IC2.16 (VDD), IC3.12 (VDDPL), IC3.13 (VDDL), IC4.1 (VCC1), IC5.1 (VCC1), Q5.1 (G), Q7.1 (G), Q8.1 (G), Q9.1 (G), R52.1, R53.1, R54.1, R55.1, U2.36 (3V3)
+5V: 5V_supply1.2, IC1.16 (VDD), IC7.16 (VDD), R34.1, R36.1, R40.1
+5VA: C16.1, C17.1, C18.1, IC6.5 (OUT), J10.3, R47.1, R60.1, U1.3 (VDD)
+5VD: 5VD_supply1.2, I2C_0.2, I2C_1.2, R56.1, R57.1, R58.1, R59.1, U2.39 (VSYS)
+5VP: I2C1.2, IC6.1 (IN)
+12V: 12V_supply1.2, C13.1, C14.1, IC4.6 (VCC2), IC5.6 (VCC2), R8.1, R24.1, R25.1, R28.1
ADC_1_CS: C9.1, IC3.19 (~CS), U2.19 (GPIO14)
ADC_SPI_CLK: IC3.18 (SCLK), U2.4 (GPIO2)
ADC_SPI_MISO: IC3.16 (SDO), U2.6 (GPIO4)
ADC_SPI_MOSI: IC3.17 (SDI), U2.5 (GPIO3)
AIN_1: C22.1, D9.1 (K), IC3.3 (AIN1), R45.2, R46.1
AIN_2: C21.1, D8.1 (K), IC3.4 (AIN2), R43.2, R44.1
AIN_3: C12.1, IC3.6 (AIN3), R32.2, R33.1
ALARM_1_STATUS_3V3: IC2.19 (BH2), R10.2, R29.1, U2.29 (GPIO22)
ALARM_2_STATUS_3V3: IC2.20 (BH1), R30.2, R31.1, U2.27 (GPIO21)
ALARM_CLEAR_3V3: R1.1, U2.26 (GPIO20)
ALARM_CLEAR_5V: IC1.20 (BH1), Q6.1 (G), R15.2, R16.1
COUT1: IC3.14 (COUT1), U2.15 (GPIO11)
COUT2: IC3.15 (COUT2), U2.20 (GPIO15)
EXT_CONT_5: EXT_CON1.5, Q6.3 (D)
EXT_CONT_6: EXT_CON1.6, Q4.3 (D)
EXT_CONT_14: EXT_CON1.14, IC2.2 (AH2), R34.2, R35.1
EXT_CONT_15: EXT_CON1.15, IC2.1 (AH1), R36.2, R37.1
EXT_CONT_18: EXT_CON1.18, Q3.3 (D)
EXT_CONT_21: C3.1, EXT_CON1.21, R27.2
EXT_CONT_22: C4.1, EXT_CON1.22, R42.2
EXT_CONT_24: EXT_CON1.24, R32.1
FC_terminals: FC_V1.2, R43.1, R45.1
GND: 5V_supply1.1, 12V_supply1.1, C1.2, C3.2, C4.2, C5.2, C6.1, C7.1, C12.2, C13.2, C14.2, C21.2, C22.2, D1.1 (K), D2.1 (K), D3.1 (K), D4.1 (K), D7.1 (K), D8.2 (A), D9.2 (A), EXT_CON1.1, EXT_CON1.10, EXT_CON1.19, EXT_CON1.23, FC_V1.1, IC1.15 (GND), IC2.5 (COM_1), IC2.6 (COM_2), IC3.2 (AGND_1), IC3.5 (AGND_2), IC3.8 (AGND_3), IC3.10 (GNDF), IC4.5 (GND2), IC5.5 (GND2), IC7.15 (GND), Q1.2 (S), Q2.2 (S), Q3.2 (S), Q4.2 (S), Q6.2 (S), Q10.2 (S), Q11.2 (S), Q12.2 (S), R13.1, R15.1, R17.1, R19.1, R21.1, R23.2, R26.2, R33.2, R35.2, R37.2, R41.2, R44.2, R46.2
GNDA: C15.2, C16.2, C17.2, C18.2, I2C1.1, IC6.2 (GND), J10.2, R39.2, U1.2 (CH1-), U1.6 (VSS), U1.9 (VSS)
GNDD: 5VD_supply1.1, C2.1, C8.1, C9.2, C10.2, C11.1, D5.1 (K), D6.1 (K), I2C_0.1, I2C_1.1, IC1.5 (COM_1), IC1.6 (COM_2), IC2.15 (GND), IC3.11 (GNDL), IC4.3 (IN-), IC4.4 (GND1), IC5.3 (IN-), IC5.4 (GND1), IC7.5 (COM_1), IC7.6 (COM_2), R2.2, R4.2, R6.2, R9.2, R10.1, R12.2, R30.1, U2.3 (GND), U2.8 (GND), U2.13 (GND), U2.18 (GND), U2.23 (GND), U2.28 (GND), U2.38 (GND), U2.42 (GND), UART_0.3, UART_1.3, flags1.3
HiNet_1: IC4.8 (OUT-), R50.1
HiNet_2: IGBT_1_Gate1.1, IGBT_1_Gate1.2, R50.2, R51.1
HiNet_3: IC4.7 (OUT+), R51.2
HiNet_4: IC5.8 (OUT-), R48.1
HiNet_5: IGBT_2_Gate1.1, IGBT_2_Gate1.2, R48.2, R49.1
HiNet_6: IC5.7 (OUT+), R49.2
IGBT_1_ON: IC4.2 (IN+), U2.10 (GPIO7)
IGBT_2_ON: IC5.2 (IN+), U2.14 (GPIO10)
IN_flag: U2.7 (GPIO5), flags1.1
unnamed: C1.1, C6.2, IC3.9 (VDDF)
unnamed: C5.1, C7.2, IC3.1 (REF)
unnamed: C15.1, IC6.3 (EN)
unnamed: D1.2 (A), R16.2
unnamed: D2.2 (A), R18.2
unnamed: D3.2 (A), R20.2
unnamed: D4.2 (A), R14.2
unnamed: D5.2 (A), R29.2
unnamed: D6.2 (A), R31.2
unnamed: D7.2 (A), R22.2
unnamed: IC1.1 (AH1), R1.2, R2.1
unnamed: IC1.2 (AH2), R3.2, R4.1
unnamed: IC1.3 (AH3), R5.2, R6.1
unnamed: IC7.1 (AH1), R7.2, R9.1
unnamed: IC7.2 (AH2), R11.2, R12.1
unnamed: J10.1, R38.1
unnamed: Q1.3 (D), Q2.1 (G), R8.2, R23.1
unnamed: Q2.3 (D), R24.2, R27.1
unnamed: Q10.3 (D), Q11.1 (G), R25.2, R26.1
unnamed: Q11.3 (D), R28.2, R42.1
unnamed: Q3.1 (G), Q12.3 (D), R40.2, R41.1
unnamed: R38.2, R39.1, U1.1 (CH1+)
OUT_flag: U2.9 (GPIO6), flags1.2
SCL_0_3V3: Q8.2 (S), R54.2, U2.2 (GPIO1)
SCL_0_5V: I2C_0.4, Q8.3 (D), R56.2
SCL_1_3V3: Q9.2 (S), R55.2, U2.32 (GPIO27_ADC1)
SCL_1_5V: I2C_1.4, Q9.3 (D), R57.2
SCL_clamp_5V: I2C1.4, R47.2, U1.5 (SCL)
SDA_0_3V3: Q5.2 (S), R52.2, U2.1 (GPIO0)
SDA_0_5V: I2C_0.3, Q5.3 (D), R58.2
SDA_1_3V3: Q7.2 (S), R53.2, U2.31 (GPIO26_ADC0)
SDA_1_5V: I2C_1.3, Q7.3 (D), R59.2
SDA_clamp_5V: I2C1.3, R60.2, U1.4 (SDA)
SET_ALARM_3V3: R5.1, U2.24 (GPIO18)
SET_ALARM_5V: IC1.18 (BH3), Q4.1 (G), R19.2, R20.1
SET_CC_3V3: R7.1, U2.22 (GPIO17)
SET_CC_5V: IC7.20 (BH1), Q1.1 (G), R13.2, R14.1
SET_CV_3V3: R11.1, U2.21 (GPIO16)
SET_CV_5V: IC7.19 (BH2), Q10.1 (G), R21.2, R22.1
SET_ONOFF_3V3: R3.1, U2.25 (GPIO19)
SET_ONOFF_5V: IC1.19 (BH2), Q12.1 (G), R17.2, R18.1
UART0_RX: U2.17 (GPIO13), UART_0.2
UART0_TX: U2.16 (GPIO12), UART_0.1
UART1_RX: U2.12 (GPIO9), UART_1.2
UART1_TX: U2.11 (GPIO8), UART_1.1

Notes on the sheet:
Current Clamp Circuit
High power resistors
External Control Connector (EXT_CONT) Circuits
Isolated ADC
IGBT Drivers
ADC Input Voltage Dividers
I2C Level shifters
10R on OUT- should be 3R3

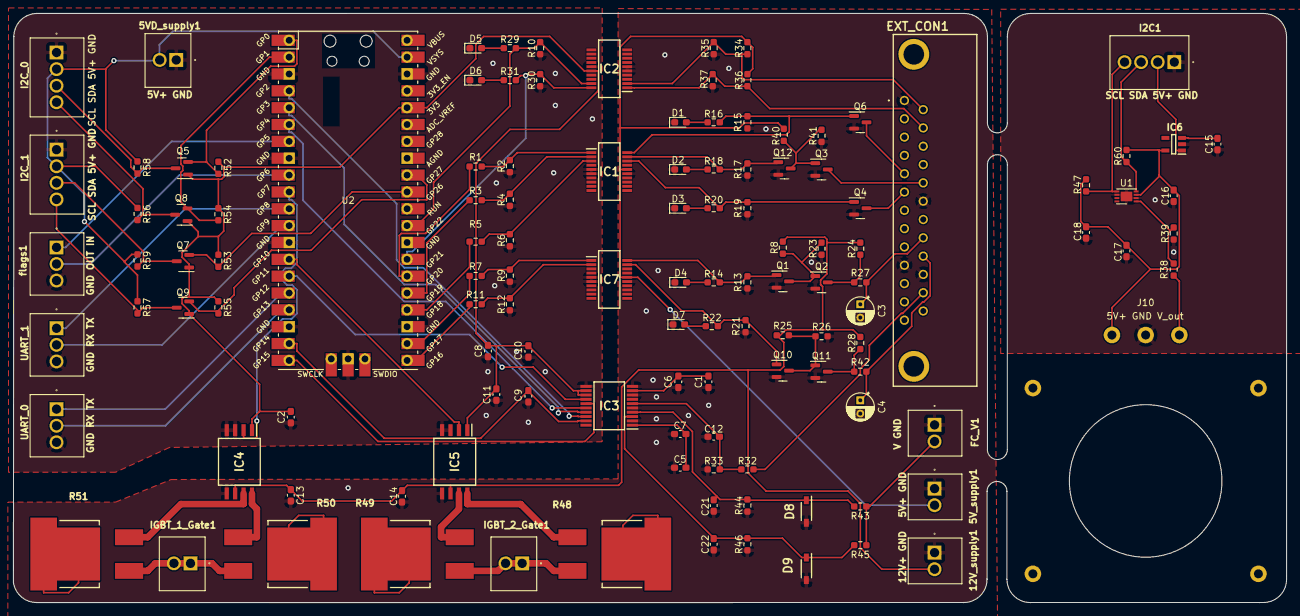
[picture p11: board controlCircuit.kicad_pcb from above]

Board: 2 copper layers, 191.9 x 88.8 mm, 124 parts (0 on the bottom side), 85 nets.
