OisinS13/FC_IP_rig/Hardware/CVM/iso_adc_cvm.kicad_pcb

## KiCad design Hardware/CVM/iso_adc_cvm.kicad_pcb (2022-11-23)

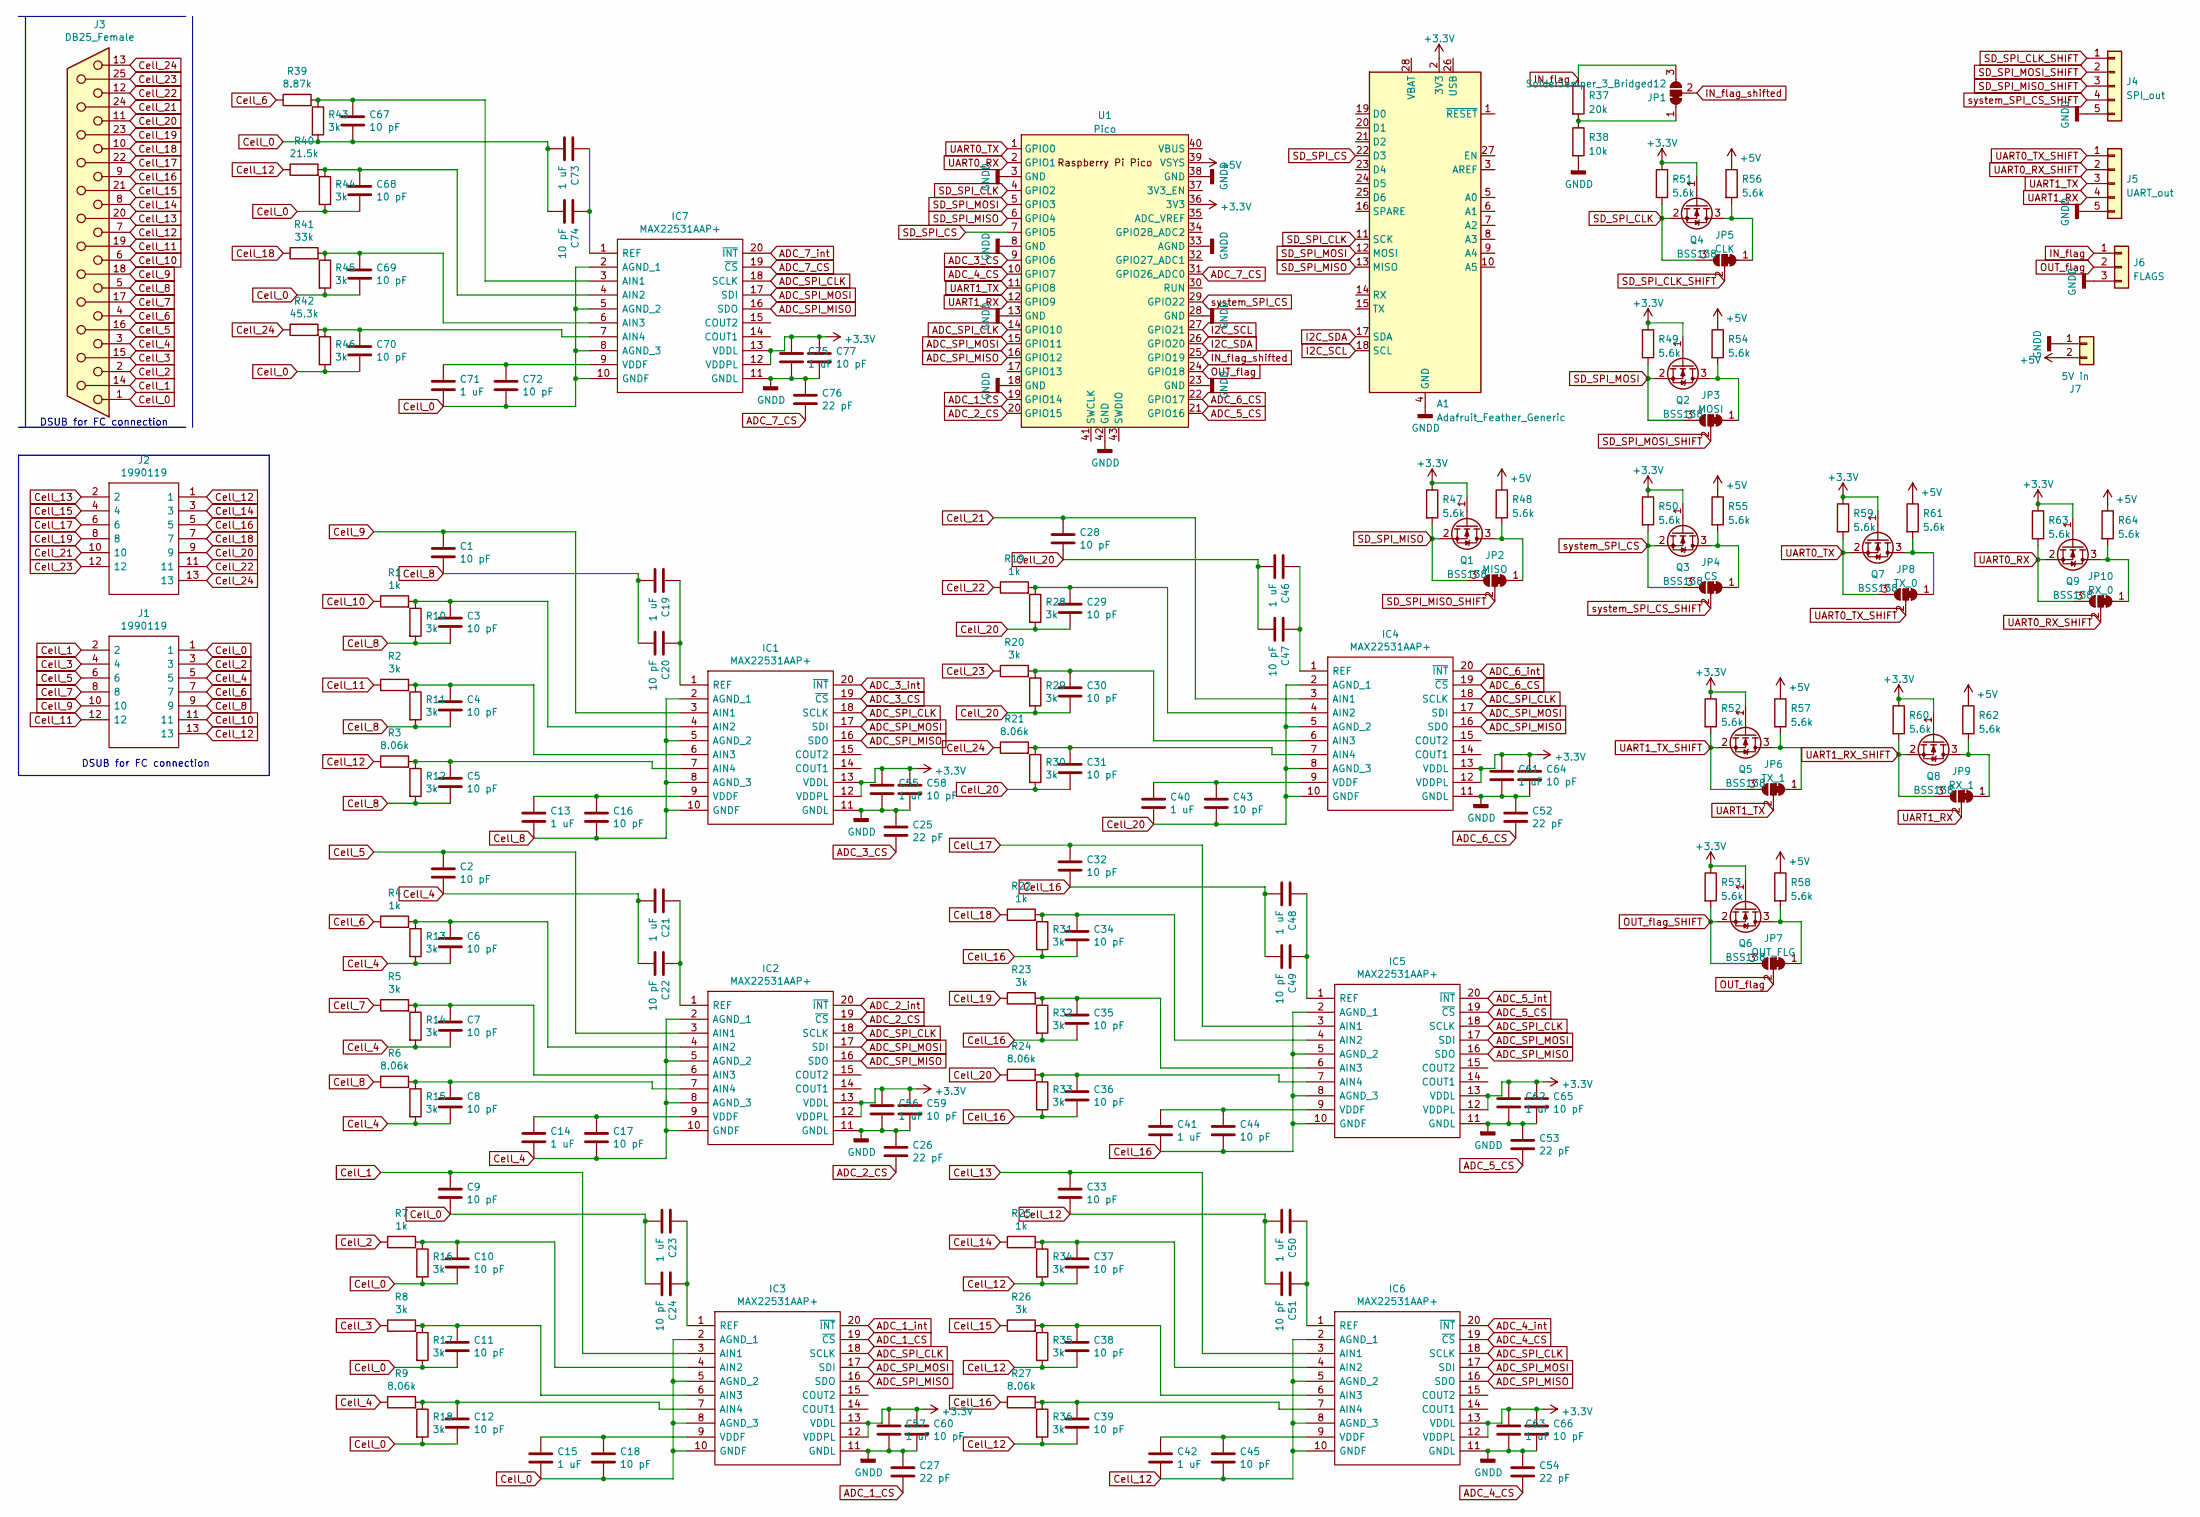
[picture p12: schematic iso_adc_cvm.kicad_sch]

Parts:
A1: Adafruit_Feather_Generic; Adafruit_Feather
C1, C2, C3, C4, C5, C6, C7, C8, C9, C10, C11, C12, C16, C17, C18, C20, C22, C24, C28, C29, C30, C31, C32, C33, C34, C35, C36, C37, C38, C39, C43, C44, C45, C47, C49, C51, C58, C59, C60, C64, C65, C66, C67, C68, C69, C70, C72, C74, C77: 10 pF; C_0603_1608Metric_Pad1.08x0.95mm_HandSolder
C13, C14, C15, C19, C21, C23, C40, C41, C42, C46, C48, C50, C55, C56, C57, C61, C62, C63, C71, C73, C75: 1 uF; C_0603_1608Metric_Pad1.08x0.95mm_HandSolder
C25, C26, C27, C52, C53, C54, C76: 22 pF; C_0603_1608Metric_Pad1.08x0.95mm_HandSolder
IC1, IC2, IC3, IC4, IC5, IC6, IC7: MAX22531AAP+; SOP65P778X199-20N; Mouser Part Number 700-MAX22531AAP+
J1, J2: 1990119; Mouser Part Number 651-1990119
J3: DB25_Female; DSUB-25_Female_Horizontal_P2.77x2.84mm_EdgePinOffset9.90mm_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
J4: SPI_out; 1881587
J5: UART_out; 1881587
J6: FLAGS; 1963544
J7: 5V in; 1963531
JP1: SolderJumper_3_Bridged12; SolderJumper-3_P1.3mm_Bridged2Bar12_RoundedPad1.0x1.5mm
JP2: MISO; SolderJumper-3_P1.3mm_Bridged2Bar12_RoundedPad1.0x1.5mm
JP3: MOSI; SolderJumper-3_P1.3mm_Bridged2Bar12_RoundedPad1.0x1.5mm
JP4: CS; SolderJumper-3_P1.3mm_Bridged2Bar12_RoundedPad1.0x1.5mm
JP5: CLK; SolderJumper-3_P1.3mm_Bridged2Bar12_RoundedPad1.0x1.5mm
JP6: TX_1; SolderJumper-3_P1.3mm_Bridged2Bar12_RoundedPad1.0x1.5mm
JP7: OUT_FLG; SolderJumper-3_P1.3mm_Bridged2Bar12_RoundedPad1.0x1.5mm
JP8: TX_0; SolderJumper-3_P1.3mm_Bridged2Bar12_RoundedPad1.0x1.5mm
JP9: RX_1; SolderJumper-3_P1.3mm_Bridged2Bar12_RoundedPad1.0x1.5mm
JP10: RX_0; SolderJumper-3_P1.3mm_Bridged2Bar12_RoundedPad1.0x1.5mm
Q1, Q2, Q3, Q4, Q5, Q6, Q7, Q8, Q9: BSS138; SOT-23
R1, R4, R7, R19, R22, R25: 1k; R_0603_1608Metric_Pad0.98x0.95mm_HandSolder
R2, R5, R8, R10, R11, R12, R13, R14, R15, R16, R17, R18, R20, R23, R26, R28, R29, R30, R31, R32, R33, R34, R35, R36, R43, R44, R45, R46: 3k; R_0603_1608Metric_Pad0.98x0.95mm_HandSolder
R3, R6, R9, R21, R24, R27: 8.06k; R_0603_1608Metric_Pad0.98x0.95mm_HandSolder
R37: 20k; R_0603_1608Metric_Pad0.98x0.95mm_HandSolder
R38: 10k; R_0603_1608Metric_Pad0.98x0.95mm_HandSolder
R39: 8.87k; R_0603_1608Metric_Pad0.98x0.95mm_HandSolder
R40: 21.5k; R_0603_1608Metric_Pad0.98x0.95mm_HandSolder
R41: 33k; R_0603_1608Metric_Pad0.98x0.95mm_HandSolder
R42: 45.3k; R_0603_1608Metric_Pad0.98x0.95mm_HandSolder
R47, R48, R49, R50, R51, R52, R53, R54, R55, R56, R57, R58, R59, R60, R61, R62, R63, R64: 5.6k; R_0603_1608Metric_Pad0.98x0.95mm_HandSolder
U1: Pico; RPi_Pico_SMD_TH

Connections:
+3.3V: A1.2 (3V3), C55.1, C56.1, C57.1, C58.1, C59.1, C60.1, C61.1, C62.1, C63.1, C64.1, C65.1, C66.1, C75.1, C77.1, IC1.12 (VDDPL), IC1.13 (VDDL), IC2.12 (VDDPL), IC2.13 (VDDL), IC3.12 (VDDPL), IC3.13 (VDDL), IC4.12 (VDDPL), IC4.13 (VDDL), IC5.12 (VDDPL), IC5.13 (VDDL), IC6.12 (VDDPL), IC6.13 (VDDL), IC7.12 (VDDPL), IC7.13 (VDDL), Q1.1 (G), Q2.1 (G), Q3.1 (G), Q4.1 (G), Q5.1 (G), Q6.1 (G), Q7.1 (G), Q8.1 (G), Q9.1 (G), R47.1, R49.1, R50.1, R51.1, R52.1, R53.1, R59.1, R60.1, R63.1, U1.36 (3V3)
+5V: J7.2, R48.1, R54.1, R55.1, R56.1, R57.1, R58.1, R61.1, R62.1, R64.1, U1.39 (VSYS)
ADC_1_CS: C27.2, IC3.19 (~CS), U1.19 (GPIO14)
ADC_1_int: IC3.20 (~INT)
ADC_2_CS: C26.2, IC2.19 (~CS), U1.20 (GPIO15)
ADC_2_int: IC2.20 (~INT)
ADC_3_CS: C25.2, IC1.19 (~CS), U1.9 (GPIO6)
ADC_3_int: IC1.20 (~INT)
ADC_4_CS: C54.2, IC6.19 (~CS), U1.10 (GPIO7)
ADC_4_int: IC6.20 (~INT)
ADC_5_CS: C53.2, IC5.19 (~CS), U1.21 (GPIO16)
ADC_5_int: IC5.20 (~INT)
ADC_6_CS: C52.2, IC4.19 (~CS), U1.22 (GPIO17)
ADC_6_int: IC4.20 (~INT)
ADC_7_CS: C76.2, IC7.19 (~CS), U1.31 (GPIO26_ADC0)
ADC_7_int: IC7.20 (~INT)
ADC_SPI_CLK: IC1.18 (SCLK), IC2.18 (SCLK), IC3.18 (SCLK), IC4.18 (SCLK), IC5.18 (SCLK), IC6.18 (SCLK), IC7.18 (SCLK), U1.14 (GPIO10)
ADC_SPI_MISO: IC1.16 (SDO), IC2.16 (SDO), IC3.16 (SDO), IC4.16 (SDO), IC5.16 (SDO), IC6.16 (SDO), IC7.16 (SDO), U1.16 (GPIO12)
ADC_SPI_MOSI: IC1.17 (SDI), IC2.17 (SDI), IC3.17 (SDI), IC4.17 (SDI), IC5.17 (SDI), IC6.17 (SDI), IC7.17 (SDI), U1.15 (GPIO11)
Cell_0: C9.2, C10.2, C11.2, C12.2, C15.2, C18.2, C23.2, C24.2, C67.2, C68.2, C69.2, C70.2, C71.2, C72.2, C73.2, C74.2, IC3.2 (AGND_1), IC3.5 (AGND_2), IC3.8 (AGND_3), IC3.10 (GNDF), IC7.2 (AGND_1), IC7.5 (AGND_2), IC7.8 (AGND_3), IC7.10 (GNDF), J1.1, J3.1, R16.2, R17.2, R18.2, R43.2, R44.2, R45.2, R46.2
Cell_1: C9.1, IC3.3 (AIN1), J1.2, J3.14
Cell_2: J1.3, J3.2, R7.1
Cell_3: J1.4, J3.15, R8.1
Cell_4: C2.2, C6.2, C7.2, C8.2, C14.2, C17.2, C21.2, C22.2, IC2.2 (AGND_1), IC2.5 (AGND_2), IC2.8 (AGND_3), IC2.10 (GNDF), J1.5, J3.3, R9.1, R13.2, R14.2, R15.2
Cell_5: C2.1, IC2.3 (AIN1), J1.6, J3.16
Cell_6: J1.7, J3.4, R4.1, R39.1
Cell_7: J1.8, J3.17, R5.1
Cell_8: C1.2, C3.2, C4.2, C5.2, C13.2, C16.2, C19.2, C20.2, IC1.2 (AGND_1), IC1.5 (AGND_2), IC1.8 (AGND_3), IC1.10 (GNDF), J1.9, J3.5, R6.1, R10.2, R11.2, R12.2
Cell_9: C1.1, IC1.3 (AIN1), J1.10, J3.18
Cell_10: J1.11, J3.6, R1.1
Cell_11: J1.12, J3.19, R2.1
Cell_12: C33.2, C37.2, C38.2, C39.2, C42.2, C45.2, C50.2, C51.2, IC6.2 (AGND_1), IC6.5 (AGND_2), IC6.8 (AGND_3), IC6.10 (GNDF), J1.13, J2.1, J3.7, R3.1, R34.2, R35.2, R36.2, R40.1
Cell_13: C33.1, IC6.3 (AIN1), J2.2, J3.20
Cell_14: J2.3, J3.8, R25.1
Cell_15: J2.4, J3.21, R26.1
Cell_16: C32.2, C34.2, C35.2, C36.2, C41.2, C44.2, C48.2, C49.2, IC5.2 (AGND_1), IC5.5 (AGND_2), IC5.8 (AGND_3), IC5.10 (GNDF), J2.5, J3.9, R27.1, R31.2, R32.2, R33.2
Cell_17: C32.1, IC5.3 (AIN1), J2.6, J3.22
Cell_18: J2.7, J3.10, R22.1, R41.1
Cell_19: J2.8, J3.23, R23.1
Cell_20: C28.2, C29.2, C30.2, C31.2, C40.2, C43.2, C46.2, C47.2, IC4.2 (AGND_1), IC4.5 (AGND_2), IC4.8 (AGND_3), IC4.10 (GNDF), J2.9, J3.11, R24.1, R28.2, R29.2, R30.2
Cell_21: C28.1, IC4.3 (AIN1), J2.10, J3.24
Cell_22: J2.11, J3.12, R19.1
Cell_23: J2.12, J3.25, R20.1
Cell_24: J2.13, J3.13, R21.1, R42.1
GNDD: A1.4 (GND), C25.1, C26.1, C27.1, C52.1, C53.1, C54.1, C55.2, C56.2, C57.2, C58.2, C59.2, C60.2, C61.2, C62.2, C63.2, C64.2, C65.2, C66.2, C75.2, C76.1, C77.2, IC1.11 (GNDL), IC2.11 (GNDL), IC3.11 (GNDL), IC4.11 (GNDL), IC5.11 (GNDL), IC6.11 (GNDL), IC7.11 (GNDL), J4.5, J5.5, J6.3, J7.1, R38.2, U1.3 (GND), U1.8 (GND), U1.13 (GND), U1.18 (GND), U1.23 (GND), U1.28 (GND), U1.33 (AGND), U1.38 (GND), U1.42 (GND)
I2C_SCL: A1.18 (SCL), U1.27 (GPIO21)
I2C_SDA: A1.17 (SDA), U1.26 (GPIO20)
IN_flag: J6.1, JP1.3 (B), R37.1
IN_flag_shifted: JP1.2 (C), U1.25 (GPIO19)
unnamed: C3.1, IC1.4 (AIN2), R1.2, R10.1
unnamed: C4.1, IC1.6 (AIN3), R2.2, R11.1
unnamed: C5.1, IC1.7 (AIN4), R3.2, R12.1
unnamed: C6.1, IC2.4 (AIN2), R4.2, R13.1
unnamed: C7.1, IC2.6 (AIN3), R5.2, R14.1
unnamed: C8.1, IC2.7 (AIN4), R6.2, R15.1
unnamed: C10.1, IC3.4 (AIN2), R7.2, R16.1
unnamed: C11.1, IC3.6 (AIN3), R8.2, R17.1
unnamed: C12.1, IC3.7 (AIN4), R9.2, R18.1
unnamed: C13.1, C16.1, IC1.9 (VDDF)
unnamed: C14.1, C17.1, IC2.9 (VDDF)
unnamed: C15.1, C18.1, IC3.9 (VDDF)
unnamed: C19.1, C20.1, IC1.1 (REF)
unnamed: C21.1, C22.1, IC2.1 (REF)
unnamed: C23.1, C24.1, IC3.1 (REF)
unnamed: C29.1, IC4.4 (AIN2), R19.2, R28.1
unnamed: C30.1, IC4.6 (AIN3), R20.2, R29.1
unnamed: C31.1, IC4.7 (AIN4), R21.2, R30.1
unnamed: C34.1, IC5.4 (AIN2), R22.2, R31.1
unnamed: C35.1, IC5.6 (AIN3), R23.2, R32.1
unnamed: C36.1, IC5.7 (AIN4), R24.2, R33.1
unnamed: C37.1, IC6.4 (AIN2), R25.2, R34.1
unnamed: C38.1, IC6.6 (AIN3), R26.2, R35.1
unnamed: C39.1, IC6.7 (AIN4), R27.2, R36.1
unnamed: C40.1, C43.1, IC4.9 (VDDF)
unnamed: C41.1, C44.1, IC5.9 (VDDF)
unnamed: C42.1, C45.1, IC6.9 (VDDF)
unnamed: C46.1, C47.1, IC4.1 (REF)
unnamed: C48.1, C49.1, IC5.1 (REF)
unnamed: C50.1, C51.1, IC6.1 (REF)
unnamed: C67.1, IC7.3 (AIN1), R39.2, R43.1
unnamed: C68.1, IC7.4 (AIN2), R40.2, R44.1
unnamed: C69.1, IC7.6 (AIN3), R41.2, R45.1
unnamed: C70.1, IC7.7 (AIN4), R42.2, R46.1
unnamed: C71.1, C72.1, IC7.9 (VDDF)
unnamed: C73.1, C74.1, IC7.1 (REF)
unnamed: JP1.1 (A), R37.2, R38.1
unnamed: JP2.1 (A), Q1.3 (D), R48.2
unnamed: JP3.1 (A), Q2.3 (D), R54.2
unnamed: JP4.1 (A), Q3.3 (D), R55.2
unnamed: JP5.1 (A), Q4.3 (D), R56.2
unnamed: JP6.1 (A), Q5.3 (D), R57.2
unnamed: JP7.1 (A), Q6.3 (D), R58.2
unnamed: JP8.1 (A), Q7.3 (D), R61.2
unnamed: JP9.1 (A), Q8.3 (D), R62.2
unnamed: JP10.1 (A), Q9.3 (D), R64.2
OUT_flag: J6.2, JP7.2 (C), U1.24 (GPIO18)
OUT_flag_SHIFT: JP7.3 (B), Q6.2 (S), R53.2
SD_SPI_CLK: A1.11 (SCK), JP5.3 (B), Q4.2 (S), R51.2, U1.4 (GPIO2)
SD_SPI_CLK_SHIFT: J4.1, JP5.2 (C)
SD_SPI_CS: A1.22 (D3), U1.7 (GPIO5)
SD_SPI_MISO: A1.13 (MISO), JP2.3 (B), Q1.2 (S), R47.2, U1.6 (GPIO4)
SD_SPI_MISO_SHIFT: J4.3, JP2.2 (C)
SD_SPI_MOSI: A1.12 (MOSI), JP3.3 (B), Q2.2 (S), R49.2, U1.5 (GPIO3)
SD_SPI_MOSI_SHIFT: J4.2, JP3.2 (C)
UART0_RX: JP10.3 (B), Q9.2 (S), R63.2, U1.2 (GPIO1)
UART0_RX_SHIFT: J5.2, JP10.2 (C)
UART0_TX: JP8.3 (B), Q7.2 (S), R59.2, U1.1 (GPIO0)
UART0_TX_SHIFT: J5.1, JP8.2 (C)
UART1_RX: J5.4, JP9.2 (C), U1.12 (GPIO9)
UART1_RX_SHIFT: JP9.3 (B), Q8.2 (S), R60.2
UART1_TX: J5.3, JP6.2 (C), U1.11 (GPIO8)
UART1_TX_SHIFT: JP6.3 (B), Q5.2 (S), R52.2
system_SPI_CS: JP4.3 (B), Q3.2 (S), R50.2, U1.29 (GPIO22)
system_SPI_CS_SHIFT: J4.4, JP4.2 (C)

Notes on the sheet:
DSUB for FC connection

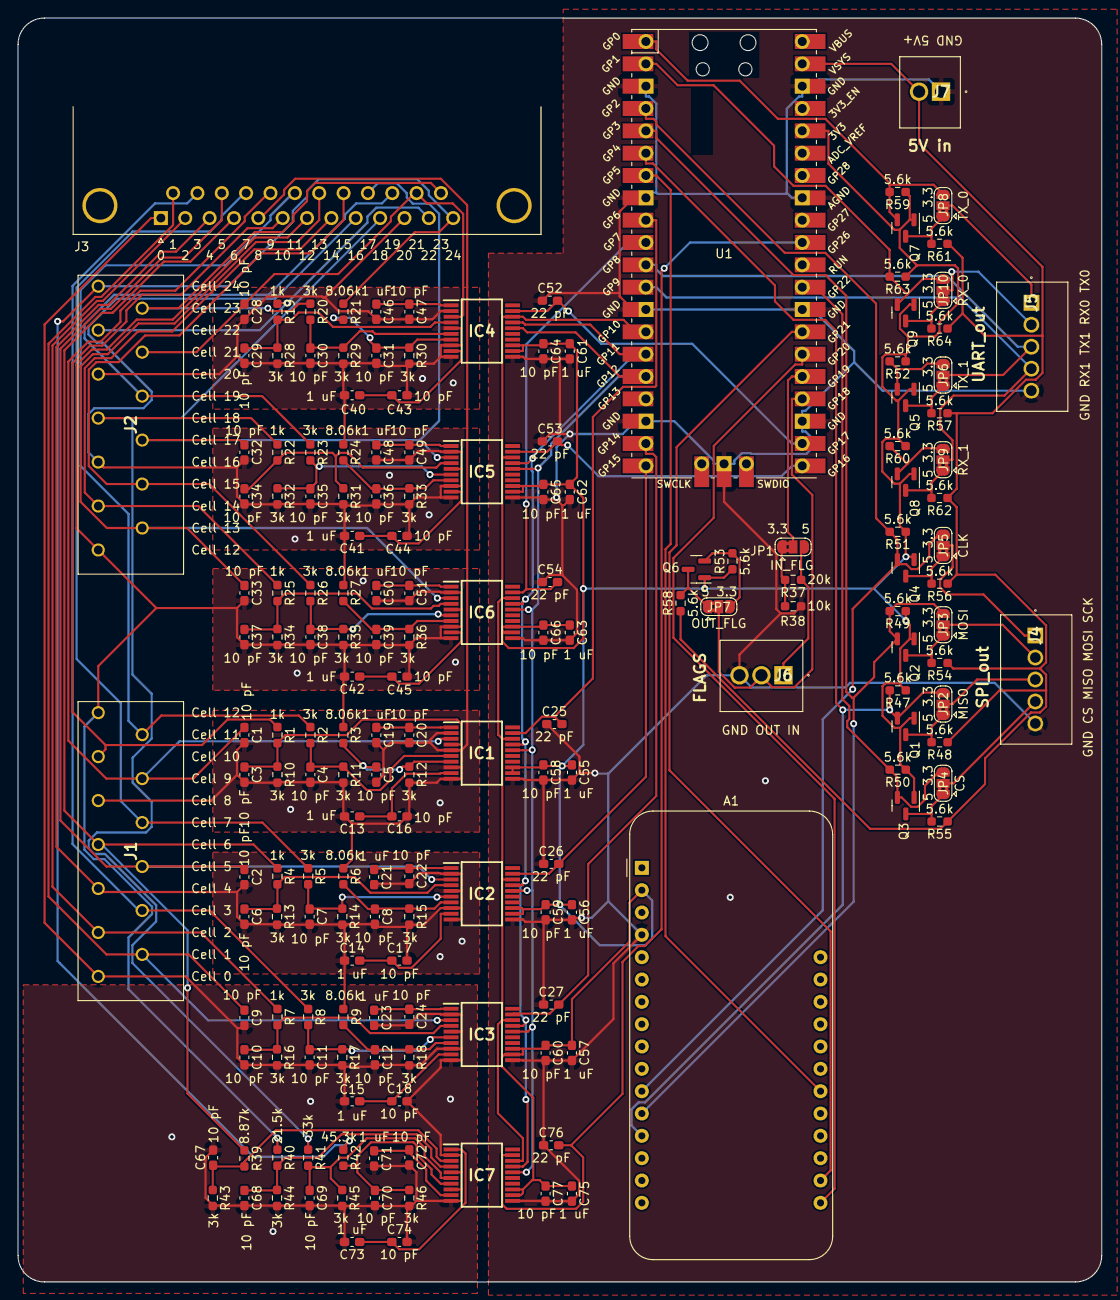
[picture p13: board iso_adc_cvm.kicad_pcb from above]

Board: 2 copper layers, 123.2 x 143.8 mm, 176 parts (0 on the bottom side), 107 nets.
