OisinS13/FC_IP_rig/Hardware/gas sniffer/gas sniffer.kicad_pcb

## KiCad design Hardware/gas sniffer/gas sniffer.kicad_pcb (2022-11-23)

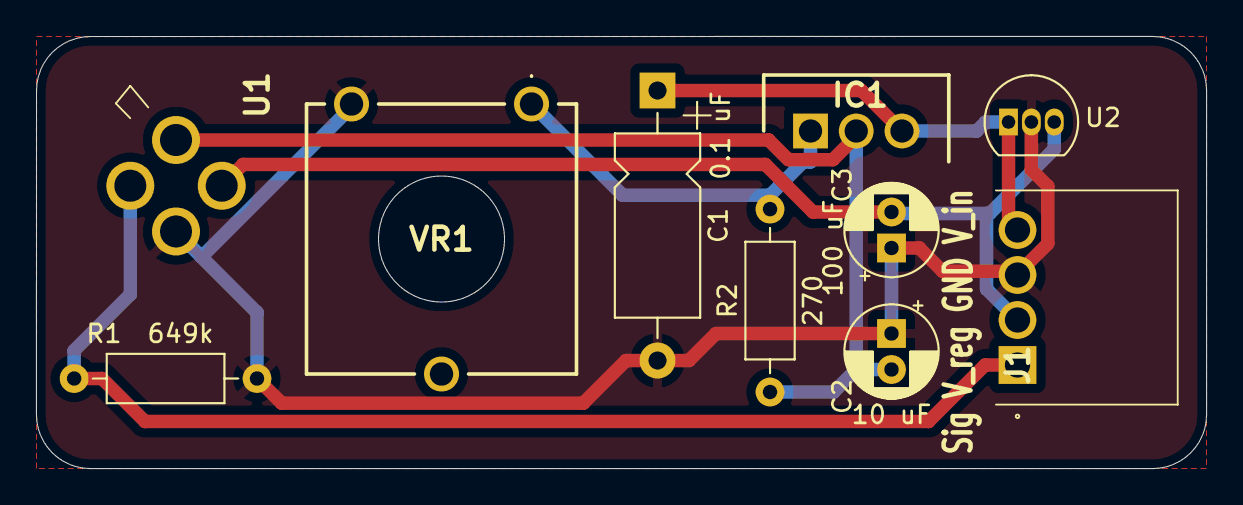
[picture p14: board gas sniffer.kicad_pcb from above]

Board: 2 copper layers, 65.0 x 24.0 mm, 10 parts (0 on the bottom side), 6 nets.

Parts:
C1: 0.1 uF; CP_Axial_L10.0mm_D4.5mm_P15.00mm_Horizontal
C2: 10 uF; CP_Radial_D5.0mm_P2.00mm
C3: 100 uF; CP_Radial_D5.0mm_P2.00mm
IC1: LM317MBTG; TO254P482X997X2018-3P
J1: Conn_01x04; 1963447
R1: 649k; R_Axial_DIN0207_L6.3mm_D2.5mm_P10.16mm_Horizontal
R2: 270; R_Axial_DIN0207_L6.3mm_D2.5mm_P10.16mm_Horizontal
U1: SGAS701
U2: LM2931AZ-5.0_TO92; TO-92_Inline
VR1: PT15NV15-102A1010-S; PT15NV15102A1010S

Connections:
GND: C1.2, C2.1, C3.1, J1.3, R1.1, U1.3, U2.2, VR1.E1
unnamed: C2.2, IC1.2, R2.1, U1.1
unnamed: IC1.1, R2.2, VR1.A1
VDD: C1.1, IC1.3, J1.4, U2.1
V_out: J1.1, R1.2, U1.4
V_reg: C3.2, J1.2, U1.2, U2.3
