OisinS13/FC_IP_rig/Control code/Load_controller/main/main.ino

#include <SPI.h>
#include "RTClib.h"
#include "SerialTransfer.h"
#include "CommandHandler.h"  // Part of MegunoLink library
RTC_PCF8523 rtc;

// Pin specificaton
#define SDA_0_pin 0
#define SCL_0_pin 1
#define ISO_ADC_CLK_pin 2
#define ISO_ADC_MOSI_pin 3  // (TX)
#define ISO_ADC_MISO_pin 4  // (RX)
#define in_flag_pin 5
#define out_flag_pin 6
#define igbt_1_pin 7
#define TX_1_pin 8
#define RX_1_pin 9
#define igbt_2_pin 10
#define COUT_1_pin 11
#define TX_0_pin 12
#define RX_0_pin 13
#define ISO_ADC_CS_pin 14
#define COUT_2_pin 15
#define CV_pin 16
#define CC_pin 17
#define set_alarm_pin 18
#define load_pin 19
#define clear_pin 20
#define alarm_2_pin 21
#define alarm_1_pin 22
#define SDA_1_pin 26
#define SCL_1_pin 27

SerialTransfer DataLogger;
SerialTransfer CVM;


// // Program states:
// uint32_t ref_time = 0;
// uint32_t data_time = 0;
// uint32_t data_interval = 10;

// Set maximum values
// Units: mA, mV, W, uS
uint32_t max_current = 200000;
uint32_t max_voltage = 24000;
uint32_t max_power = 3000;
uint32_t max_short_time = 200000;

// // Reference variables:
// // refs: Current, voltage, power
// // units: mA, mV,  W
// uint32_t V_ref = 24;
// uint32_t I_ref = 0;
// uint32_t P_ref = 0;

// split uf reference tracking to cc, cv cp

// Operating mode
// Available:
// 1 Reference tracking           (REF)
// 2 Maximum power point tracking (MPPT)
// 3 Maximum efficiency tracking  (MET)
// uint8_t op_mode = 1;

// // Short circuit parameters
// uint32_t short_period = 0;
// uint32_t time_stamp = 0;
// uint8_t igbt_selected = 1;

// PWM Settings
uint32_t PWM_range = 24000;
uint32_t PWM_freq = 10000;

// flags
bool alarm_1 = false;
bool alarm_2 = false;
bool alarm_ext = false;
bool load_flag = false;
bool short_flag = false;
bool USB_flag = false;
bool USB_Data = false;
bool Core0_boot_flag = 0;
bool Core1_boot_flag = 0;

// // ADC channels
// uint16_t voltage_spike = 0;
// uint16_t voltage = 0;
// uint16_t bank_current = 0;



// // CVM packet
// struct PKT {
//   char cmd;
//   bool flag;
//   uint16_t value;
// } rx_msg, tx_msg;


// uint32_t Last_data_time = 0;
uint32_t Data_interval = 100;

// Perturbation protocol
// 0 = Not in perturbation protocol
// 1 = Perturbation requested internally
// 2 = UART request sent out, waiting for acknowledgment
// 3 = UART acknowledgment received
// 4 = Hardware trigger out sent, waiting for acknowledgment
// 5 = Hardware trigger in received, perturbing
// 6 = Perturbation complete
uint8_t Perturbation_protocol_counter = 0;
uint16_t Perturbation_timeout = 10000;  //in mS
uint32_t Perturbation_last_event = 0;

// Data packet
struct DATA {

  uint32_t I_ref;  //mA
  uint32_t V_ref;  //mV
  uint32_t P_ref;  //W
  uint32_t V_fc;
  uint32_t V_fc_spike;
  uint32_t I_monitor;
  uint32_t I_clamp;
  uint32_t time_stamp;
  // Operating mode
  // Available:
  // 1 Reference tracking           (REF)
  // 2 Maximum power point tracking (MPPT)
  // 3 Maximum efficiency tracking  (MET)
  uint8_t op_mode;

  bool alarm_1;
  bool alarm_2;
  bool alarm_ext;
  bool load_status;
} data;

uint32_t Last_short_time = 0;

#define Cycles_per_step 5
struct Optimisation_parameters {
  uint8_t Optimisation_strategy = 0;             //0 = No optimisation,1 = fixed parameters, 2 = 2DOF P&O, 3 = Adaptive tau, P&O delta, 4 Adaptive tau used to optimise delta
  uint32_t Parameters[2] = { 50000, 30000000 };  //0=duration, 1=period, in uS
  bool Parameter_flag = 0;                       //if 0, optimising duration, if 1, optimising period
  uint32_t Mean_V_time = 0;
  float Mean_V_time_sum = 0;
  float Mean_V_sum = 0;
  double Mean_V_per_cycle[Cycles_per_step];
  double Mean_V_per_step[2] = { 0, 0 };
  uint8_t Cycle_counter = 0;
  // uint8_t Cycles_per_step=5;
  int32_t Step_size[2] = { 10000, 10000000 };       //(signed)
  uint32_t Minimum_step_size[2] = { 500, 500000 };  //0 element is for duration, 1 element is for period
  uint8_t Step_size_multiplier = 5;                 //After switching parameters, increase step size to start re-optimising parameter
  int32_t Adaptive_tau_hysteresis_window = 0;       //How far below the Mean voltage does the sack voltage have to go before it triggers a perturbation
} OptimisationParameters;

CommandHandler<20, 50> SerialCommandHandler(Serial, '<', '>');  //number of commands, then buffer length of command strings



// boot core 0
void setup() {
  delay(1000);
  USB_flag = USB_setup(115200, 1000);  //Iniitalise the USB, and set flag if present

  // Init communication to interface
  Serial1.setRX(RX_0_pin);
  Serial1.setTX(TX_0_pin);
  Serial1.setPollingMode(true);
  Serial1.begin(115200);
  CVM.begin(Serial1);

  //Set pins for I2C
  Wire.setSDA(SDA_0_pin);
  Wire.setSCL(SCL_0_pin);

  SerialCommandHandler.SetDefaultHandler(Cmd_Unknown);
  SerialCommandHandler.AddCommand(F("Set_Current"), USB_Set_Current);
  SerialCommandHandler.AddCommand(F("Set_Voltage"), USB_Set_Voltage);
  SerialCommandHandler.AddCommand(F("Set_Power"), USB_Set_Power);
  SerialCommandHandler.AddCommand(F("Set_Load"), USB_Set_Load);
  SerialCommandHandler.AddCommand(F("Set_Mode"), USB_Set_Mode);
  SerialCommandHandler.AddCommand(F("Clear_Alarms"), USB_Clear_Alarms);
  SerialCommandHandler.AddCommand(F("Set_Delta"), USB_Set_Delta);
  SerialCommandHandler.AddCommand(F("Set_Tau"), USB_Set_Tau);
  SerialCommandHandler.AddCommand(F("Set_Strategy"), USB_Set_Strategy);
  SerialCommandHandler.AddCommand(F("Set_Delta_step"), USB_Set_Delta_step);
  SerialCommandHandler.AddCommand(F("Set_Tau_step"), USB_Set_Tau_step);
  SerialCommandHandler.AddCommand(F("Set_adaptive_window"), USB_Set_adaptive_window);
  SerialCommandHandler.AddCommand(F("USB_Data_write"), USB_Data_Write);
  //editme add perturbation variable commands

  // Pinmodes
  pinMode(LED_BUILTIN, OUTPUT);
  pinMode(load_pin, OUTPUT);
  pinMode(CC_pin, OUTPUT);
  pinMode(CV_pin, OUTPUT);
  pinMode(clear_pin, OUTPUT);
  pinMode(alarm_1_pin, INPUT);
  pinMode(alarm_2_pin, INPUT);
  pinMode(load_pin, OUTPUT);
  pinMode(ISO_ADC_CS_pin, OUTPUT_12MA);
  pinMode(in_flag_pin, INPUT);
  pinMode(out_flag_pin, OUTPUT_12MA);
  pinMode(set_alarm_pin, OUTPUT);
  pinMode(igbt_1_pin, OUTPUT_12MA);
  pinMode(igbt_2_pin, OUTPUT_12MA);

  digitalWrite(igbt_1_pin, LOW);  // Close igbt 1
  digitalWrite(igbt_2_pin, LOW);  // Close igbt 2

  // PWM frequency
  analogWriteFreq(PWM_freq);
  analogWriteRange(PWM_range);

  // SPI setup
  //Set the correct SPI pins for the SPI
  SPI.setSCK(ISO_ADC_CLK_pin);
  SPI.setTX(ISO_ADC_MOSI_pin);
  SPI.setRX(ISO_ADC_MISO_pin);
  SPI.setCS(LED_BUILTIN);
  digitalWrite(ISO_ADC_CS_pin, HIGH);

  SPI.begin(0);
  SPI.beginTransaction(SPISettings(10000000, MSBFIRST, SPI_MODE0));
  SPI.endTransaction();


  // initial outputs
  digitalWrite(set_alarm_pin, HIGH);  // Alarm is activated by pulling low
  digitalWrite(clear_pin, HIGH);

  // Init communication to data logger
  Serial2.setRX(RX_1_pin);
  Serial2.setTX(TX_1_pin);
  Serial2.setPollingMode(true);
  Serial2.begin(115200);
  DataLogger.begin(Serial2);

  // running
  // digitalWrite(LED_BUILTIN, HIGH);
  Core0_boot_flag = 1;
  while (!Core1_boot_flag) {
  }
}



// boot core 1
void setup1() {
  while (!Core0_boot_flag) {
  }


  Core1_boot_flag = 1;
}



void loop() {
  Mean_V_data();
  if (millis() - data.time_stamp > Data_interval) {
    aggData();
    dataWrite();
  }
  if (OptimisationParameters.Optimisation_strategy == 0) {
    //Do "no optimisation" stuff here
  } else if (OptimisationParameters.Optimisation_strategy == 1) {
    if (micros() - Last_short_time > OptimisationParameters.Parameters[1]) {
      Perturbation_protocol_counter = 1;
      Perturbation_last_event = millis();
    }
  } else if (OptimisationParameters.Optimisation_strategy == 2) {
    //Do "2DOF P&O" stuff here
    if (micros() - Last_short_time > OptimisationParameters.Parameters[1]) {
      OptimisationParameters.Cycle_counter++;
      if (OptimisationParameters.Cycle_counter >= Cycles_per_step) {
        Perturb_and_observ_calcs_2DOF();
        OptimisationParameters.Cycle_counter = 0;
      }
      Perturbation_protocol_counter = 1;
      Perturbation_last_event = millis();
    }
  } else if (OptimisationParameters.Optimisation_strategy == 3) {
    if ((data.V_fc - OptimisationParameters.Adaptive_tau_hysteresis_window) < OptimisationParameters.Mean_V_per_cycle[OptimisationParameters.Cycle_counter]) {
      OptimisationParameters.Cycle_counter++;
      if (OptimisationParameters.Cycle_counter >= Cycles_per_step) {
        Perturb_and_observ_calcs_1DOF();
        OptimisationParameters.Cycle_counter = 0;
      }
      Perturbation_protocol_counter = 1;
      Perturbation_last_event = millis();
    }
  } else if (OptimisationParameters.Optimisation_strategy == 4) {
    //EDITME insert adaptive tau to optimise delta here
  }
}


void loop1() {
  if (!USB_flag) {
    USB_flag = USB_setup(115200, 1);  //Iniitalise the USB, and set flag if present
  }
  if (CVM.available()) {
    char ID = CVM.currentPacketID();
    if (ID == 'B') {
      uint8_t temporary = 0;
      CVM.rxObj(temporary);  //EDITME throw error if wrong number sent?
      if (Perturbation_protocol_counter == 2) {
        Perturbation_protocol_counter = 3;
        Perturbation_last_event = millis();
      }  //EDITME add error throwing code?
    }
  }

  // Perturbation protocol
  // 0 = Not in perturbation protocol
  // 1 = Perturbation requested internally
  // 2 = UART request sent out, waiting for acknowledgment
  // 3 = UART acknowledgment received
  // 4 = Hardware trigger out sent, waiting for acknowledgment
  // 5 = Hardware trigger in received, perturbing
  // 6 = Perturbation complete

  switch (Perturbation_protocol_counter) {
    case 0:
      break;
    case 1:
      CVM.txObj(1);
      CVM.sendData(1, 'B');
      Perturbation_protocol_counter = 2;
      Perturbation_last_event = millis();
      break;
    case 2:
      //EDITME do listening here or elsewhere?
      break;
    case 3:
      digitalWrite(out_flag_pin, HIGH);
      Perturbation_protocol_counter = 4;
      Perturbation_last_event = millis();
      break;
    case 4:
      if (digitalRead(in_flag_pin)) {
        Perturbation_protocol_counter = 5;
        executeShort(OptimisationParameters.Parameters[0]);
        OptimisationParameters.Mean_V_time = micros();
        OptimisationParameters.Mean_V_time_sum = OptimisationParameters.Mean_V_time;
        OptimisationParameters.Mean_V_sum = 0;
        OptimisationParameters.Mean_V_per_cycle[OptimisationParameters.Cycle_counter] = 0;
        Perturbation_protocol_counter = 6;
        digitalWrite(out_flag_pin, LOW);
        Perturbation_protocol_counter = 0;
      }
      break;
    case 5:
      executeShort(OptimisationParameters.Parameters[0]);
      OptimisationParameters.Mean_V_time = micros();
      OptimisationParameters.Mean_V_time_sum = OptimisationParameters.Mean_V_time;
      OptimisationParameters.Mean_V_sum = 0;
      OptimisationParameters.Mean_V_per_cycle[OptimisationParameters.Cycle_counter] = 0;
      Perturbation_protocol_counter = 6;
      digitalWrite(out_flag_pin, LOW);
      Perturbation_protocol_counter = 0;
      break;
    case 6:
      digitalWrite(out_flag_pin, LOW);
      Perturbation_protocol_counter = 0;
      break;
  }

  if (millis() - Perturbation_last_event > Perturbation_timeout) {
    Perturbation_protocol_counter = 0;
    if (USB_flag) {
      Serial.println("Perturbation protocol timeout");
    }
  }
}
