OisinS13/FC_IP_rig/Control code/Data_logger/Data_Logger/Data_Logger.ino

#include <SPI.h>
#include <SoftwareSerial.h>
#include "SdFat.h"
#include "sdios.h"
#include "FreeStack.h"
#include "RTClib.h"
#include "SerialTransfer.h"

SerialPIO UART2(10, 11, 64);
SerialPIO UART3(12, 13, 32);
SerialPIO UART4(14, 15, 32);

SerialTransfer CVM;
SerialTransfer Interface;
SerialTransfer LoadController;
SerialTransfer SafetySystem;
SerialTransfer ProcessController;

const uint8_t SD_CS_PIN = 5; 
#define SD_CONFIG SdSpiConfig(SD_CS_PIN, DEDICATED_SPI, SPI_CLOCK)
#define SPI_CLOCK SD_SCK_MHZ(50)
SdFat32 SD;
RTC_PCF8523 rtc;
File32 logfile;

#define Num_CVM_Channels 24

char Filename[27];  //Char array to determine filename

struct Fault_message {
  uint8_t Fault_code = 0;
  uint8_t Fault_detail = 0;
};
struct Fault_message Incoming_fault;

bool Core0_boot_flag = 0;  //Flag to tell Core1 that Core0 has successfully booted
bool Core1_boot_flag = 0;  //Flag to tell Core0 that Core1 has successfully booted
bool USB_flag = 0;         //Flag to indicate if USB communications are active
bool SD_boot_flag = 0;     //Flag to indicate SD successfully booted
bool RTC_flag = 0;         //Flag to indicate RTC successfully booted
bool file_ready_flag = 0;
char Error_to_file[] = ",";     //Char array for the errors to be written to the file
int Error_to_file_counter = 1;  //Counter for the length of the error to file array

struct DataFrameCVM {
  uint32_t Cell_V[28] = { 0 };  //Cell voltages in uV
  uint32_t CVM_timestamp = 0;   // timestamp in uS
};

struct DataFrameProcess {
  float CTHD_HTR_SFTY_TC[2] = { 0, 0 };        //DegC
  double CTHD_FLW = 0;                         //SLPM
  double CTHD_FLW_target = 0;                  //in SLPM
  uint16_t CTHD_FLW_output = 0;                //12 bit PWM value
  uint16_t AND_FLW_value[2] = { 0 };           //SmLPM
  uint16_t AND_FLW_target = 0;                 //SmLPM
  uint16_t AND_FLW_output = 0;                 //12 bit PWM value
  uint16_t AND_recirc_PWM = 0;                 //12 bit PWM value
  uint16_t CLNT_FLW_output = 0;                //Coolant pump 12 bit PWM value
  double Coolant_T_readings[3];                //
  uint16_t Fan_setting = 0;                    //12 bit PWM setting for collant system fan speed
  float HIH_RH[8] = { 0 };                     //Array to store converted RH data (as %)
  float HIH_T[8] = { 0 };                      //Array to store converted T data (deg C)
  uint32_t P_readings[5] = { 0, 0, 0, 0, 0 };  //Pa
  double O2_conc = 0.21;                       //
  bool CTHD_HTR = 0;                           //is the cathode heater on/off
  uint8_t Valves = 0;                          //Bit flags for what valves are set. Order is anode humidifier feed, cathode humidifier feed, anode flow controller purge, anode flow controller valve, anode purge, H2 in, N2 in
  uint32_t Process_controller_timestamp = 0;   //timestamp in mS that data was sent out
};

struct DataFrameLoad {
  //EDITME put in Load controller stuff
  uint32_t I_ref;
  uint32_t V_ref;
  uint32_t P_ref;
  uint32_t V_fc;
  uint32_t V_fc_spike;
  uint32_t I_monitor;
  uint32_t I_clamp;
  uint32_t time_stamp;

  uint8_t op_mode;

  bool alarm_1;
  bool alarm_2;
  bool alarm_ext;
  bool load_status;
};

struct DataFrameSafety {
  //EDITME put in safety system stuff
};

struct DataFrameStruct {
  uint8_t Data_source_flags;      //Flags are "To-be-saved" flag, Process controller, Safety system, Load controller, CVM
  DataFrameCVM CVM_data;          //CVM data
  DataFrameProcess Process_data;  //Process controller data
  DataFrameLoad Load_data;        //Load controller data
  DataFrameSafety Safety_data;    //Safety system data
};

#define BufferSize 4
DataFrameStruct *DataPtr[BufferSize], DataFrame[BufferSize];



void setup() {
  delay(1000);
  USB_flag = USB_setup(115200, 1000);  //Iniitalise the USB, and set flag if present//Give USB time to connect EDITME to shortest reliable time


  for (int i = 0; i < BufferSize; i++) {
    DataPtr[i] = &DataFrame[i];
  }

  Serial2.setRX(9);  //Set UART pins for UART1, to be used for Interface connection
  Serial2.setTX(8);
  // Serial2.setFIFOSize(size_t 128); //May be required for stable UART comms
  Serial2.setPollingMode(true);  //Ensure UART1 port is listening for messages
  Serial2.begin(115200);         //Initialise UART1 port
  Interface.begin(Serial2);      //Initialise Serial Transfer object for Interface connection

  Core0_boot_flag = 1;
  while (!Core1_boot_flag) {  //Wait for Core1 to finish its setup
    delay(10);
  }
}

void setup1() {

  while (!Core0_boot_flag) {  //Wait for Core0 to finish its setup
    delay(10);
  }

  Serial1.setRX(1);  //Set UART pins for UART0, to be used for CVM connection
  Serial1.setTX(0);
  Serial1.setFIFOSize(128);      //May be required for stable UART comms
  Serial1.setPollingMode(true);  //Ensure UART0 port is listening for messages
  Serial1.begin(115200);         //Initialise UART0 port
  CVM.begin(Serial1);            //Initialise Serial Transfer object for CVM connection

  UART2.begin(115200);
  LoadController.begin(UART2);

  UART3.begin(115200);
  SafetySystem.begin(UART3);

  UART4.begin(115200);
  ProcessController.begin(UART4);

  SPI.setSCK(2);  //Set the correct SPI pins for the SD SPI
  SPI.setTX(3);
  SPI.setRX(4);
  SPI.setCS(SD_CS_PIN);
  if (Serial) {
    Serial.print("Initializing SD card...");
  }

  if (!SD.begin(SD_CONFIG)) {
    FaultSend(Interface, 'f', 0x71, 0);  //Send fault for SD initialisation fault
    if (Serial) {
      Serial.println("initialization failed!");
    }
    //EDITME write error throwing code
  } else {
    SD_boot_flag = 1;
    if (Serial) {
      Serial.println("initialization done.");
    }
  }

  Wire.setSDA(20);  //Set pins for RTC I2C
  Wire.setSCL(21);

  if (!rtc.begin()) {
    if (Serial) {
      Serial.println("Couldn't find RTC");
      Serial.flush();
    }
  } else {
    RTC_flag = 1;
  }

  //EDITME Write code to throw error and ask for manual reboot of Core1 if SD or RTC boot fails

  DateTime boot_time = rtc.now();

  while (!file_ready_flag) {  //Open a write file to test writing
    file_ready_flag = Create_logfile(boot_time, &Filename[0]);
  }

   Core1_boot_flag = 1;
}

void loop() {
  while (!Core1_boot_flag) {}  //Check if Core1 has booted. Required in case of reboot over UART

  if (CVM.available()) {  //EDITME change to while?
    char ID = CVM.currentPacketID();

    if (ID == 'd') {  //Data frame
      Receive_data_frame(0x01);
    }

    if (ID == 'f') {  //Fault message
      //EDITME finish fault reading
      CVM.rxObj(Incoming_fault);                                                                                                                                //Put the fault in a structure
      Error_to_file_counter += sprintf(&Error_to_file[Error_to_file_counter], "%u-%u-%lu;", Incoming_fault.Fault_code, Incoming_fault.Fault_detail, millis());  //Append a fault, timestamp, and then a delimeter
      FaultSend(Interface, 'f', Incoming_fault.Fault_code, Incoming_fault.Fault_detail);                                                                        //Forward fault to Interface for log
    }

    if (ID == 'R') {                                                                      //CVM manual reboot request
      CVM.rxObj(Incoming_fault);                                                          //Put the fault in a structure
      FaultSend(Interface, 'R', Incoming_fault.Fault_code, Incoming_fault.Fault_detail);  //Forward request to Interface to be manually acknowledged
    }

    if (ID == 'U') {  //Cell undervoltage error
      uint32_t UV_error_flags = 0;
      CVM.rxObj(UV_error_flags);                                                                                               //Put the fault in a structure
      Error_to_file_counter += sprintf(&Error_to_file[Error_to_file_counter], "%u-%lu-%lu;", 0xF1, UV_error_flags, millis());  //Append a fault, timestamp, and then a delimeter
      FaultSend(Interface, 'U', 0xF1, 0);                                                                                      //Forward error to other systems for relevant actions to be taken
      FaultSend(LoadController, 'U', 0xF1, 0);                                                                                 //Forward error to other systems for relevant actions to be taken
      FaultSend(SafetySystem, 'U', 0xF1, 0);                                                                                   //Forward error to other systems for relevant actions to be taken
      FaultSend(ProcessController, 'U', 0xF1, 0);                                                                              //Forward error to other systems for relevant actions to be taken
    }

    if (ID == 'u') {                                  //Cell undervoltage error clear
      CVM.rxObj(Incoming_fault);                      //Put the fault in a structure
      FaultSend(Interface, 'u', 0xF1, 0xFF);          //Forward error clear to other systems for relevant actions to be taken
      FaultSend(LoadController, 'u', 0xF1, 0xFF);     //Forward error clear to other systems for relevant actions to be taken
      FaultSend(SafetySystem, 'u', 0xF1, 0xFF);       //Forward error clear to other systems for relevant actions to be taken
      FaultSend(ProcessController, 'u', 0xF1, 0xFF);  //Forward error clear to other systems for relevant actions to be taken
    }

    if (ID == 't') {                                                                                                                                            //Fault message
      CVM.rxObj(Incoming_fault);                                                                                                                                //Put the fault in a structure
      Error_to_file_counter += sprintf(&Error_to_file[Error_to_file_counter], "%u-%u-%lu;", Incoming_fault.Fault_code, Incoming_fault.Fault_detail, millis());  //Append a fault, timestamp, and then a delimeter
      FaultSend(Interface, 'f', Incoming_fault.Fault_code, Incoming_fault.Fault_detail);                                                                        //Forward fault to Interface for log
    }


    //EDITME put in other messages here
  }

  if (ProcessController.available()) {
    char ID = ProcessController.currentPacketID();

    if (ID == 'd') {  //Data frame
      Receive_data_frame(0x08);
    }

    if (ID == 'f') {  //Fault message
      //EDITME finish fault reading
      ProcessController.rxObj(Incoming_fault);                                                                                                                  //Put the fault in a structure
      Error_to_file_counter += sprintf(&Error_to_file[Error_to_file_counter], "%u-%u-%lu;", Incoming_fault.Fault_code, Incoming_fault.Fault_detail, millis());  //Append a fault, timestamp, and then a delimeter
    }

    if (ID == 'T') {                                                                                                                                                     //Temperature out of bounds
      ProcessController.rxObj(Incoming_fault);                                                                                                                           //Put the fault in a structure
      Error_to_file_counter += sprintf(&Error_to_file[Error_to_file_counter], "%u-%u-%u-%lu;", 0xF2, Incoming_fault.Fault_code, Incoming_fault.Fault_detail, millis());  //Append a fault, timestamp, and then a delimeter
      //EDITME add FMEA reactions to extreme scenarios
    }

    if (ID == 'F') {                                                                                                                                                     //Temperature out of bounds
      ProcessController.rxObj(Incoming_fault);                                                                                                                           //Put the fault in a structure
      Error_to_file_counter += sprintf(&Error_to_file[Error_to_file_counter], "%u-%u-%u-%lu;", 0xF3, Incoming_fault.Fault_code, Incoming_fault.Fault_detail, millis());  //Append a fault, timestamp, and then a delimeter
      //EDITME add FMEA reactions to extreme scenarios
    }

    if (ID == 'P') {                                                                                                                                                     //Temperature out of bounds
      ProcessController.rxObj(Incoming_fault);                                                                                                                           //Put the fault in a structure
      Error_to_file_counter += sprintf(&Error_to_file[Error_to_file_counter], "%u-%u-%u-%lu;", 0xF4, Incoming_fault.Fault_code, Incoming_fault.Fault_detail, millis());  //Append a fault, timestamp, and then a delimeter
      //EDITME add FMEA reactions to extreme scenarios
    }
    //EDITME put in other messages here
  }

  if (LoadController.available()) {
    char ID = LoadController.currentPacketID();

    if (ID == 'd') {  //Data frame
      Receive_data_frame(0x02);
    }

    if (ID == 'f') {  //Fault message
      //EDITME finish fault reading
      LoadController.rxObj(Incoming_fault);                                                                                                                     //Put the fault in a structure
      Error_to_file_counter += sprintf(&Error_to_file[Error_to_file_counter], "%u-%u-%lu;", Incoming_fault.Fault_code, Incoming_fault.Fault_detail, millis());  //Append a fault, timestamp, and then a delimeter
    }

    //EDITME put in other messages here
  }

  if (SafetySystem.available()) {
    char ID = SafetySystem.currentPacketID();

    if (ID == 'd') {  //Data frame
      Receive_data_frame(0x04);
    }

    if (ID == 'f') {  //Fault message
      //EDITME finish fault reading
      SafetySystem.rxObj(Incoming_fault);                                                                                                                       //Put the fault in a structure
      Error_to_file_counter += sprintf(&Error_to_file[Error_to_file_counter], "%u-%u-%lu;", Incoming_fault.Fault_code, Incoming_fault.Fault_detail, millis());  //Append a fault, timestamp, and then a delimeter
    }

    //EDITME put in other messages here
  }

  if ((*DataPtr[0]).Data_source_flags == 0b1111) {  //if all of the data read flag bits are set, all the data for this frame has been read from sources, so set "To-be-saved" flag
    (*DataPtr[0]).Data_source_flags |= 0x10;
  }

  if ((*DataPtr[0]).Data_source_flags & 0x10) {  //If the "To-be-saved" bit is set
                                                 //EDITME update append code for new structs

    char Data_to_file[] = "\n";  //Initialise char array, beginning with a new line character //EDITME specify size

    int j = 1;  //starts at 1 to account for newline chracter

    //Append CVM data
    for (int i = 0; i < Num_CVM_Channels; i++) {
      j += sprintf(&Data_to_file[j], "%lu,", (*DataPtr[0]).CVM_data.Cell_V[i]);  //Append a reading, and then a delimeter
    }
    j += sprintf(&Data_to_file[j], "%lu,", (*DataPtr[0]).CVM_data.CVM_timestamp);  //Append a timestamp, and then a delimeter

    //Append process controller data
    for (int i = 0; i < 2; i++) {
      j += sprintf(&Data_to_file[j], "%f,", (*DataPtr[0]).Process_data.CTHD_HTR_SFTY_TC[i]);  //Append a reading, and then a delimeter
    }
    j += sprintf(&Data_to_file[j], "%f,", (*DataPtr[0]).Process_data.CTHD_FLW);         //Append a reading, and then a delimeter
    j += sprintf(&Data_to_file[j], "%f,", (*DataPtr[0]).Process_data.CTHD_FLW_target);  //Append a reading, and then a delimeter
    j += sprintf(&Data_to_file[j], "%u,", (*DataPtr[0]).Process_data.CTHD_FLW_output);  //Append a reading, and then a delimeter
    for (int i = 0; i < 2; i++) {
      j += sprintf(&Data_to_file[j], "%u,", (*DataPtr[0]).Process_data.AND_FLW_value[i]);  //Append a reading, and then a delimeter
    }
    j += sprintf(&Data_to_file[j], "%u,", (*DataPtr[0]).Process_data.AND_FLW_target);   //Append a reading, and then a delimeter
    j += sprintf(&Data_to_file[j], "%u,", (*DataPtr[0]).Process_data.AND_FLW_output);   //Append a reading, and then a delimeter
    j += sprintf(&Data_to_file[j], "%u,", (*DataPtr[0]).Process_data.AND_recirc_PWM);   //Append a reading, and then a delimeter
    j += sprintf(&Data_to_file[j], "%u,", (*DataPtr[0]).Process_data.CLNT_FLW_output);  //Append a reading, and then a delimeter
    for (int i = 0; i < 3; i++) {
      j += sprintf(&Data_to_file[j], "%f,", (*DataPtr[0]).Process_data.Coolant_T_readings[i]);  //Append a reading, and then a delimeter
    }
    j += sprintf(&Data_to_file[j], "%u,", (*DataPtr[0]).Process_data.Fan_setting);  //Append a reading, and then a delimeter
    for (int i = 0; i < 8; i++) {
      j += sprintf(&Data_to_file[j], "%f,", (*DataPtr[0]).Process_data.HIH_RH[i]);  //Append a reading, and then a delimeter
    }
    for (int i = 0; i < 8; i++) {
      j += sprintf(&Data_to_file[j], "%f,", (*DataPtr[0]).Process_data.HIH_T[i]);  //Append a reading, and then a delimeter
    }
    for (int i = 0; i < 5; i++) {
      j += sprintf(&Data_to_file[j], "%lu,", (*DataPtr[0]).Process_data.P_readings[i]);  //Append a reading, and then a delimeter
    }
    j += sprintf(&Data_to_file[j], "%f,", (*DataPtr[0]).Process_data.O2_conc);                        //Append a reading, and then a delimeter
    j += sprintf(&Data_to_file[j], "%u,", (*DataPtr[0]).Process_data.CTHD_HTR);                       //Append a reading, and then a delimeter
    j += sprintf(&Data_to_file[j], "%u,", (*DataPtr[0]).Process_data.Valves);                         //Append a reading, and then a delimeter
    j += sprintf(&Data_to_file[j], "%lu,", (*DataPtr[0]).Process_data.Process_controller_timestamp);  //Append a reading, and then a delimeter

    //Append Load contorller data
    j += sprintf(&Data_to_file[j], "%lu,", (*DataPtr[0]).Load_data.I_ref);       //Append a reading, and then a delimeter
    j += sprintf(&Data_to_file[j], "%lu,", (*DataPtr[0]).Load_data.V_ref);       //Append a reading, and then a delimeter
    j += sprintf(&Data_to_file[j], "%lu,", (*DataPtr[0]).Load_data.P_ref);       //Append a reading, and then a delimeter
    j += sprintf(&Data_to_file[j], "%lu,", (*DataPtr[0]).Load_data.V_fc);        //Append a reading, and then a delimeter
    j += sprintf(&Data_to_file[j], "%lu,", (*DataPtr[0]).Load_data.V_fc_spike);  //Append a reading, and then a delimeter
    j += sprintf(&Data_to_file[j], "%lu,", (*DataPtr[0]).Load_data.I_monitor);   //Append a reading, and then a delimeter
    j += sprintf(&Data_to_file[j], "%lu,", (*DataPtr[0]).Load_data.I_clamp);     //Append a reading, and then a delimeter
    j += sprintf(&Data_to_file[j], "%lu,", (*DataPtr[0]).Load_data.time_stamp);  //Append a reading, and then a delimeter
    j += sprintf(&Data_to_file[j], "%u,", (*DataPtr[0]).Load_data.op_mode);      //Append a reading, and then a delimeter
    j += sprintf(&Data_to_file[j], "%u,", (*DataPtr[0]).Load_data.alarm_1);      //Append a reading, and then a delimeter
    j += sprintf(&Data_to_file[j], "%u,", (*DataPtr[0]).Load_data.alarm_2);      //Append a reading, and then a delimeter
    j += sprintf(&Data_to_file[j], "%u,", (*DataPtr[0]).Load_data.alarm_ext);    //Append a reading, and then a delimeter
    j += sprintf(&Data_to_file[j], "%u,", (*DataPtr[0]).Load_data.load_status);  //Append a reading, and then a delimeter


    //EDITME add safety controller data append

    logfile.write(&Data_to_file, j);                       //Write the whole data string to the file
    logfile.sync();                                        //Save data to disc
    logfile.write(&Error_to_file, Error_to_file_counter);  //Write the whole error string to the file
    logfile.sync();                                        //Save data to disc
    memset(Error_to_file, 0, Error_to_file_counter);
    Error_to_file[0] = ',';
    Error_to_file_counter = 1;
    // DataQueue.shift();
    // DataFrameStruct Temporary;
    // (*DataPtr[0]) = Temporary;
    DataFrameStruct *DataPtr_temp = DataPtr[0];
    for (int i = 0; i < (BufferSize - 1); i++) {
      DataPtr[i] = DataPtr[i + 1];
    }
    DataPtr[BufferSize] = DataPtr_temp;
  }
}

void loop1() {
}
