OisinS13/FC_IP_rig/(commit log)

2022-11-18 Added load controller message types in messages.csv
    [messages.csv]
2022-11-28 data and msg transfer from and to load controller
    [messages.csv]
